Mon0x4A/custom-keyboard/resources/Kailh-Choc-Switch-Specifications.webp

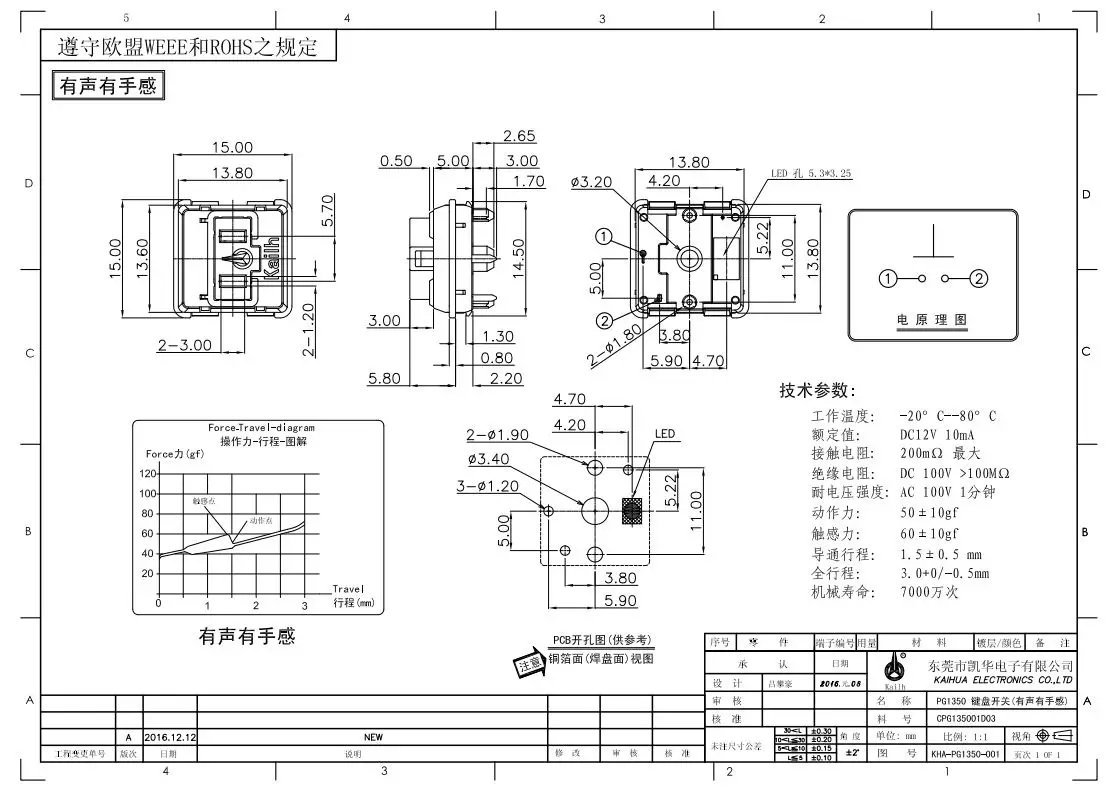
resources/Kailh-Choc-Switch-Specifications.webp
