Mon0x4A/custom-keyboard/resources/mxSwitchMechanicalDrawing.png

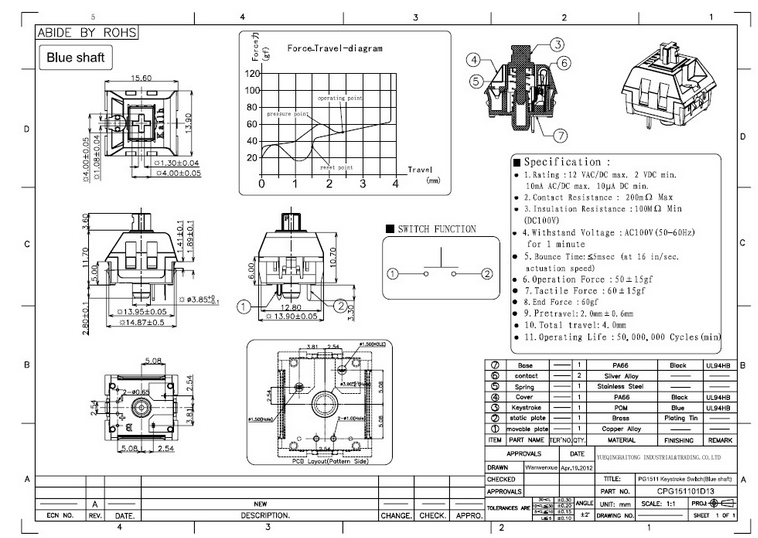
resources/mxSwitchMechanicalDrawing.png
