Mon0x4A/custom-keyboard/resources/pi-pico-pinout-diagram.png

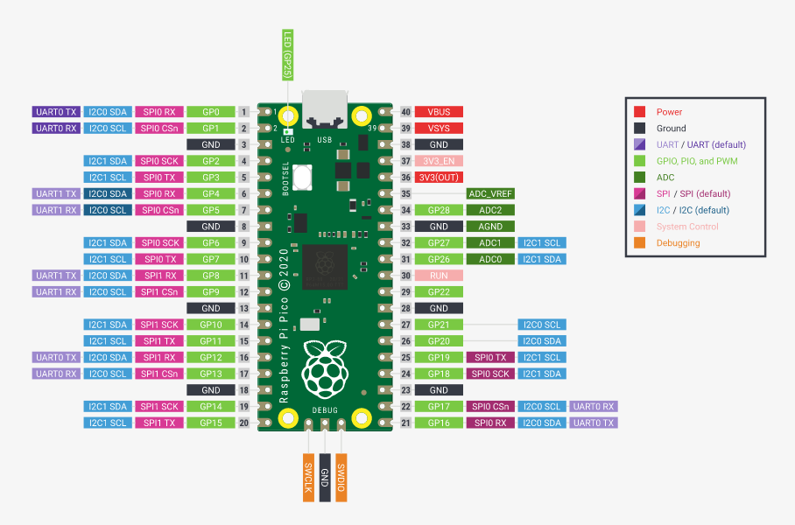
resources/pi-pico-pinout-diagram.png
