Mon0x4A/custom-keyboard/resources/stl/keyboardMk2.stl

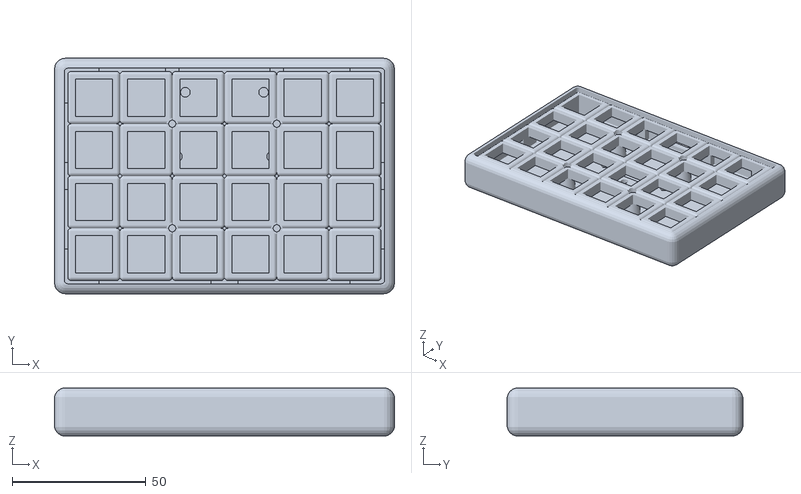
[picture p4: CAD file, 2023-02-18]
resources/stl/keyboardMk2.stl
126.9 x 87.9 x 17.9
