Mon0x4A/custom-keyboard/scad/cases/datahand-palm-rest.stl

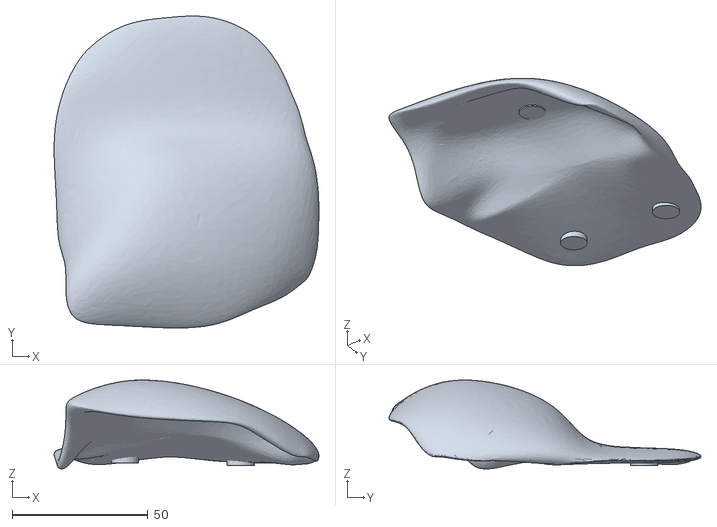
[picture p5: CAD file, 2024-03-18]
scad/cases/datahand-palm-rest.stl
97.5 x 114.8 x 32.7
