Mon0x4A/custom-keyboard/scad/lpk_dactyl/croissant-left.3mf

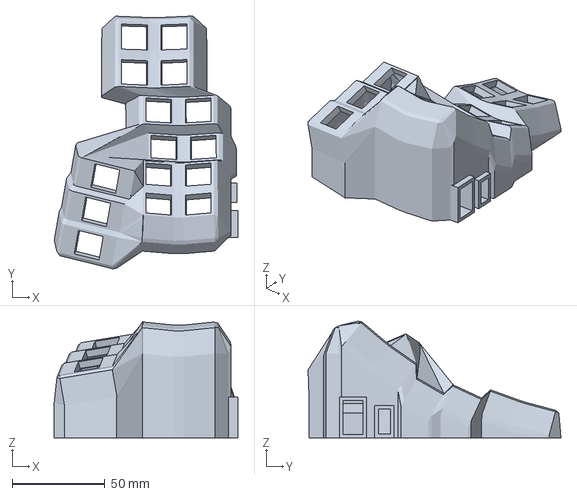
[picture p6: CAD file, 2025-09-13]
scad/lpk_dactyl/croissant-left.3mf
99.2 x 136.7 x 63.2 mm
