Mon0x4A/custom-keyboard/resources/stl/cap-shank.stl

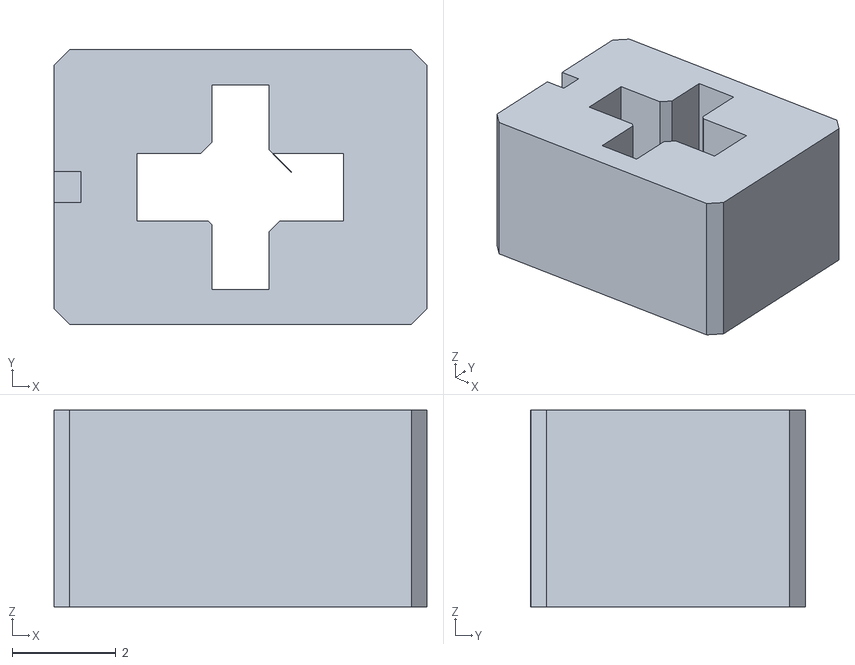
[picture p7: CAD file, 2022-06-14]
resources/stl/cap-shank.stl
7.20 x 5.30 x 3.80
