Mon0x4A/custom-keyboard/resources/stl/switch_mx.stl

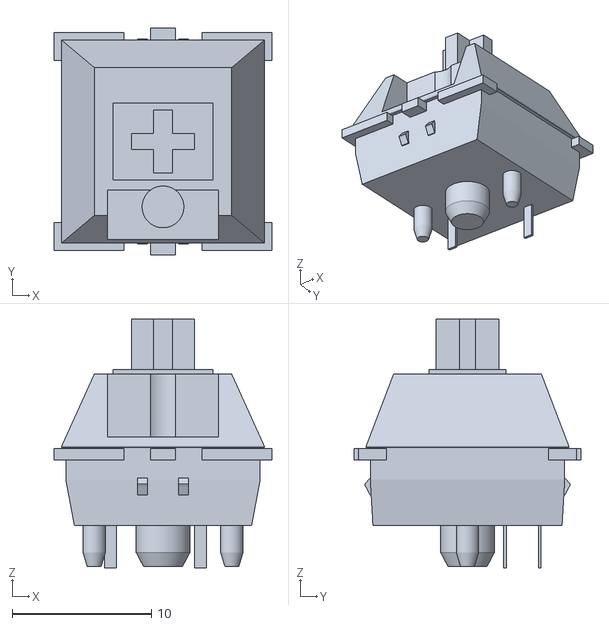
[picture p8: CAD file, 2022-06-13]
resources/stl/switch_mx.stl
15.6 x 16.3 x 17.9
