Mon0x4A/custom-keyboard/scad/lpk_dactyl/lpk_dactyl_mk2.scad

difference()
union()
{
translate([0, 0, -31.58])
    import("croissant-left.stl");
translate([100, -10, 0])
    cube([15, 30, 15]);
}
