Mon0x4A/custom-keyboard/(list of files, cad)

Other CAD files:
scad/lpk_dactyl/croissant-right.3mf
scad/keyboardMk1.scad
scad/keyboardMk2.scad
scad/keyboardMk4.scad
scad/keyboardMk6.scad
scad/backplateLeft.scad
scad/kailhKeycapMk2.scad
scad/keybordLeft.scad
scad/lpk_dactyl/key_cover.scad
scad/lpk_dactyl/usbc_mount.scad
scad/lpk_dactyl/croissant-left.stl
scad/lpk_dactyl/croissant-right.stl
