Mon0x4A/custom-keyboard/kicad/mskp/pico_ctrl_board_primary_Mk2_rev0/pico_ctrl_board_primary_Mk2_rev0.kicad_pcb

## KiCad design kicad/mskp/pico_ctrl_board_primary_Mk2_rev0/pico_ctrl_board_primary_Mk2_rev0.kicad_pcb (2024-12-22)

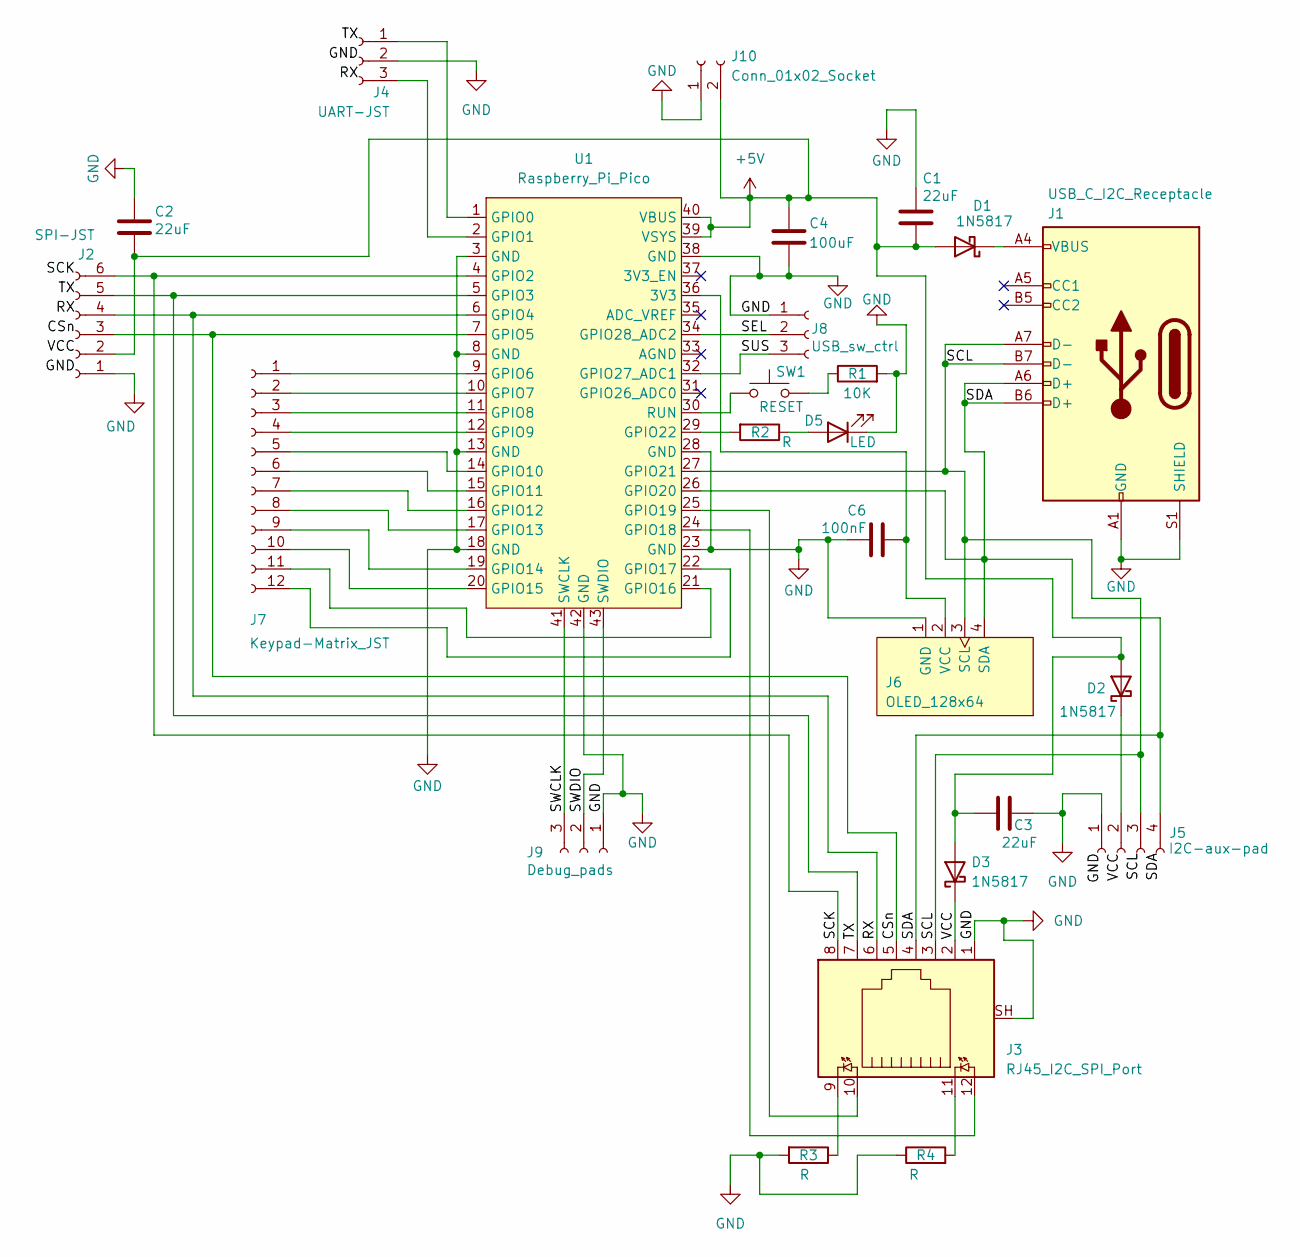
[picture p9: schematic pico_ctrl_board_primary_Mk2_rev0.kicad_sch]

Parts:
C1, C2, C3: 22uF; C_1206_3216Metric_Pad1.33x1.80mm_HandSolder
C4: 100uF; C_1206_3216Metric_Pad1.33x1.80mm_HandSolder
C6: 100nF; C_1206_3216Metric_Pad1.33x1.80mm_HandSolder
D1, D2, D3: 1N5817; D_DO-41_SOD81_P10.16mm_Horizontal
D5: LED; LED_0805_2012Metric_Pad1.15x1.40mm_HandSolder
J1: USB_C_I2C_Receptacle; USB_C_Receptacle_GCT_USB4110
J2: SPI-JST; JST_GH_SM06B-GHS-TB_1x06-1MP_P1.25mm_Horizontal
J3: RJ45_I2C_SPI_Port; RJ45_Amphenol_RJHSE538X
J4: UART-JST; JST_SH_SM03B-SRSS-TB_1x03-1MP_P1.00mm_Horizontal
J5: I2C-aux-pad; PinHeader_1x04_P2.54mm_Vertical
J6: OLED_128x64
J7: Keypad-Matrix_JST; JST_GH_SM12B-GHS-TB_1x12-1MP_P1.25mm_Horizontal
J8: USB_sw_ctrl; PinSocket_1x03_P2.54mm_Vertical
J9: Debug_pads; PinHeader_1x03_P2.54mm_Vertical
J10: Conn_01x02_Socket; PinHeader_1x02_P2.54mm_Vertical
R1: 10K; R_Axial_DIN0207_L6.3mm_D2.5mm_P7.62mm_Horizontal
R2, R3, R4: R; R_Axial_DIN0207_L6.3mm_D2.5mm_P7.62mm_Horizontal
SW1: RESET; SW_SPST_Omron_B3FS-101xP
U1: Raspberry_Pi_Pico

Connections:
+5V: C1.1, C2.1, C3.2, C4.1, D1.2 (A), D2.2 (A), D3.2 (A), J2.2, J10.2, U1.39 (VSYS), U1.40 (VBUS)
/CSn: J2.3, J3.5, U1.7 (GPIO5)
/RX: J2.4, J3.6, U1.6 (GPIO4)
/SCK: J2.6, J3.8, U1.4 (GPIO2)
/SCL: J1.A7 (D-), J1.B7 (D-), J3.3, J5.3, J6.3 (SCL), U1.27 (GPIO21)
/SDA: J1.A6 (D+), J1.B6 (D+), J3.4, J5.4, J6.4 (SDA), U1.26 (GPIO20)
/SEL: J8.2, U1.34 (GPIO28_ADC2)
/SUS: J8.3, U1.32 (GPIO27_ADC1)
/SWCLK: J9.3, U1.41 (SWCLK)
/SWDIO: J9.2, U1.43 (SWDIO)
/TX: J2.5, J3.7, U1.5 (GPIO3)
/VCC: D3.1 (K), J3.2
GND: C1.2, C2.2, C3.1, C4.2, C6.2, D5.1 (K), J1.A1 (GND), J1.A12 (GND), J1.B1 (GND), J1.B12 (GND), J1.S1 (SHIELD), J2.1, J3.1, J3.SH, J4.2, J5.1, J6.1 (GND), J8.1, J9.1, J10.1, R1.2, R3.2, R4.1, U1.3 (GND), U1.8 (GND), U1.13 (GND), U1.18 (GND), U1.23 (GND), U1.28 (GND), U1.38 (GND), U1.42 (GND)
unnamed: D1.1 (K), J1.A4 (VBUS), J1.A9 (VBUS), J1.B4 (VBUS), J1.B9 (VBUS)
unnamed: D2.1 (K), J5.2
unnamed: D5.2 (A), R2.1
unnamed: J3.9, R3.1
unnamed: J3.11, R4.2
unnamed: J4.1, U1.1 (GPIO0)
unnamed: J4.3, U1.2 (GPIO1)
unnamed: C6.1, J6.2 (VCC), U1.36 (3V3)
unnamed: J7.1, U1.9 (GPIO6)
unnamed: J7.2, U1.10 (GPIO7)
unnamed: J7.3, U1.11 (GPIO8)
unnamed: J7.4, U1.12 (GPIO9)
unnamed: J7.5, U1.14 (GPIO10)
unnamed: J7.6, U1.15 (GPIO11)
unnamed: J7.7, U1.16 (GPIO12)
unnamed: J7.8, U1.17 (GPIO13)
unnamed: J7.9, U1.19 (GPIO14)
unnamed: J7.10, U1.20 (GPIO15)
unnamed: J7.11, U1.21 (GPIO16)
unnamed: J7.12, U1.22 (GPIO17)
unnamed: R1.1, SW1.2
unnamed: J3.12, U1.24 (GPIO18)
unnamed: J3.10, U1.25 (GPIO19)
unnamed: R2.2, U1.29 (GPIO22)
unnamed: SW1.1, U1.30 (RUN)

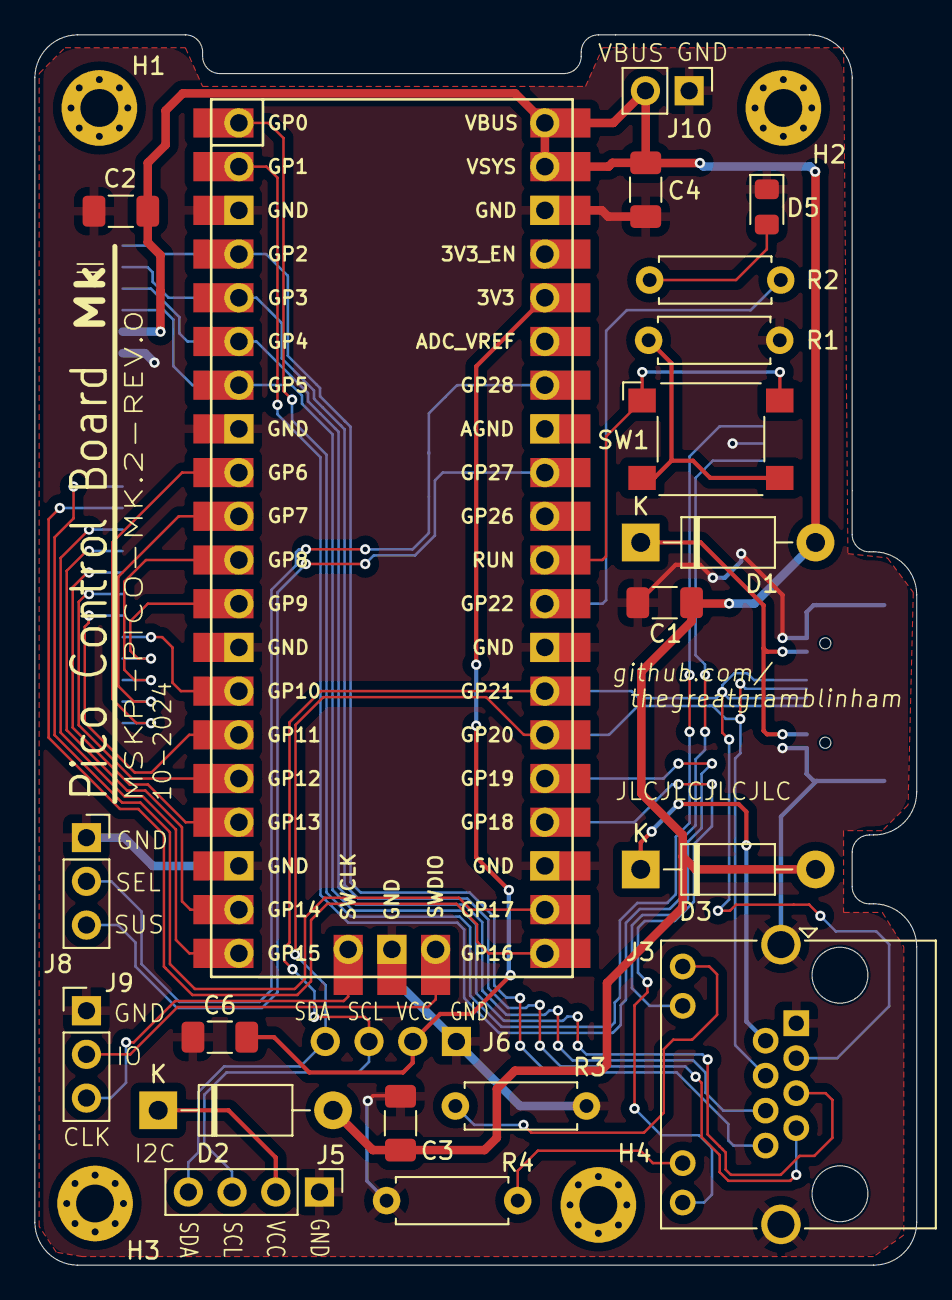
[picture p10: board pico_ctrl_board_primary_Mk2_rev0.kicad_pcb from above]

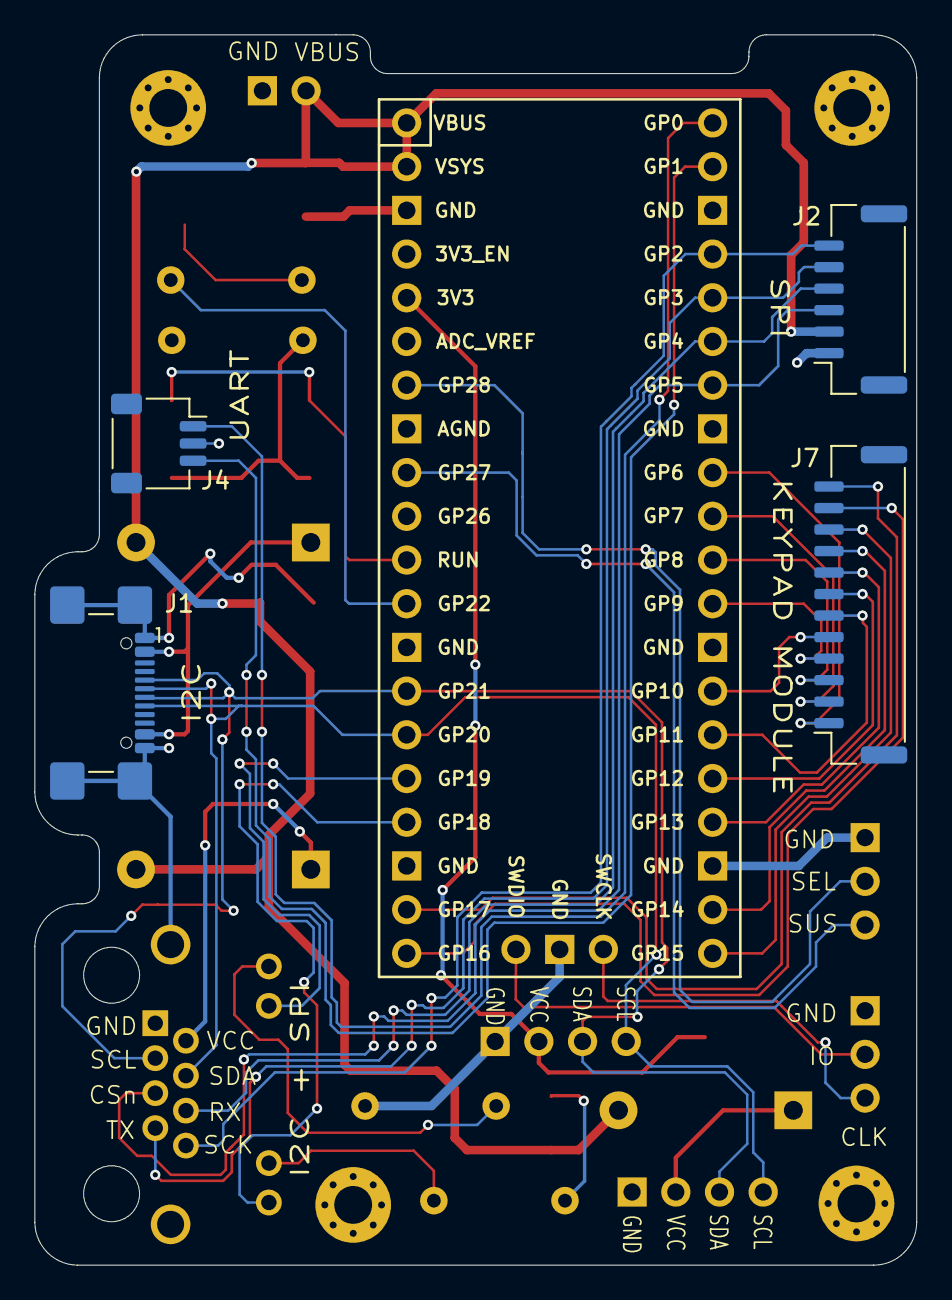
[picture p11: board pico_ctrl_board_primary_Mk2_rev0.kicad_pcb from below]

Board: 2 copper layers, 51.2 x 71.5 mm, 29 parts (4 on the bottom side), 38 nets.

Other parts of the board:
H1, H2, H3, H4: MountingHole_2.2mm_M2_Pad_Via
