Mon0x4A/custom-keyboard/kicad/mskp/io_ctrl_board_secondary_Mk2_rev0/io_ctrl_board_secondary_Mk2_rev0.kicad_pcb

## KiCad design kicad/mskp/io_ctrl_board_secondary_Mk2_rev0/io_ctrl_board_secondary_Mk2_rev0.kicad_pcb (2024-12-22)

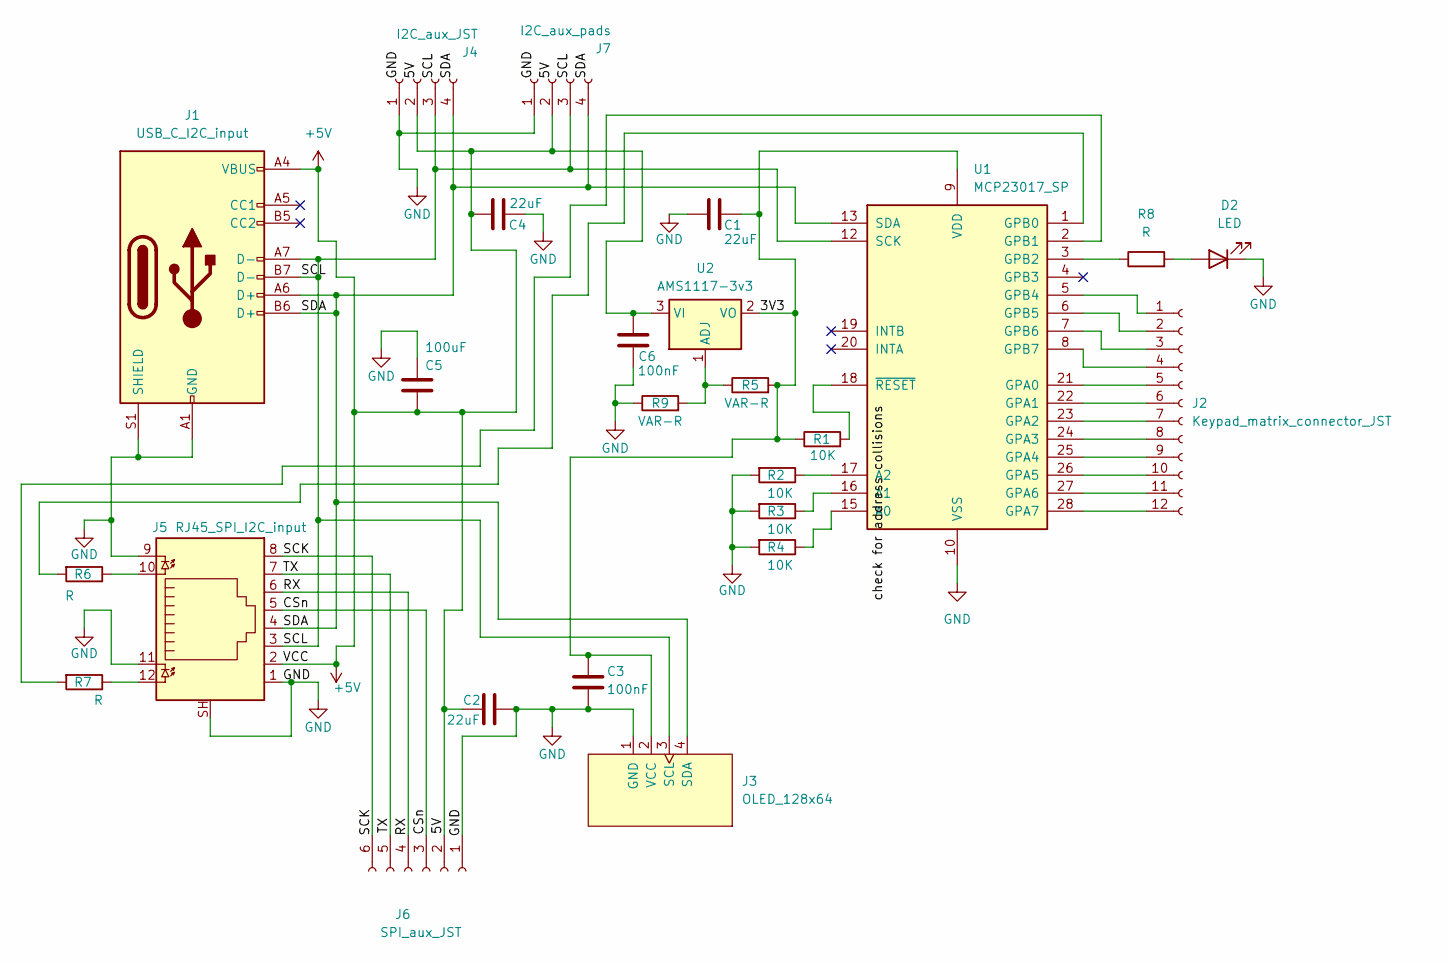
[picture p12: schematic io_ctrl_board_secondary_Mk2_rev0.kicad_sch]

Parts:
C1, C2, C4: 22uF; C_1206_3216Metric_Pad1.33x1.80mm_HandSolder
C3, C6: 100nF; C_1206_3216Metric_Pad1.33x1.80mm_HandSolder
C5: 100uF; C_1206_3216Metric_Pad1.33x1.80mm_HandSolder
D2: LED; LED_0805_2012Metric_Pad1.15x1.40mm_HandSolder
J1: USB_C_I2C_input; USB_C_Receptacle_GCT_USB4110
J2: Keypad_matrix_connector_JST; JST_GH_SM12B-GHS-TB_1x12-1MP_P1.25mm_Horizontal
J3: OLED_128x64
J4: I2C_aux_JST; JST_GH_SM04B-GHS-TB_1x04-1MP_P1.25mm_Horizontal
J5: RJ45_SPI_I2C_input; RJ45_Amphenol_RJHSE538X
J6: SPI_aux_JST; JST_GH_SM06B-GHS-TB_1x06-1MP_P1.25mm_Horizontal
J7: I2C_aux_pads; PinSocket_1x04_P2.54mm_Vertical
R1, R2, R3, R4: 10K; R_Axial_DIN0207_L6.3mm_D2.5mm_P7.62mm_Horizontal
R5, R9: VAR-R; R_Axial_DIN0207_L6.3mm_D2.5mm_P7.62mm_Horizontal
R6, R7, R8: R; R_Axial_DIN0207_L6.3mm_D2.5mm_P7.62mm_Horizontal
U1: MCP23017_SP; DIP-28_W7.62mm_Socket
U2: AMS1117-3v3; SOT-223-3_TabPin2

Connections:
+5V: C2.2, C4.1, C5.1, C6.2, J1.A4 (VBUS), J1.A9 (VBUS), J1.B4 (VBUS), J1.B9 (VBUS), J4.2, J5.2, J6.2, J7.2, U2.3 (VI)
/3V3: C1.1, C3.1, J3.2 (VCC), R1.1, R5.2, U1.9 (VDD), U2.2 (VO)
/CSn: J5.5, J6.3
/RX: J5.6, J6.4
/SCK: J5.8, J6.6
/SCL: J1.A7 (D-), J1.B7 (D-), J3.3 (SCL), J4.3, J5.3, J7.3, U1.12 (SCK)
/SDA: J1.A6 (D+), J1.B6 (D+), J3.4 (SDA), J4.4, J5.4, J7.4, U1.13 (SDA)
/TX: J5.7, J6.5
GND: C1.2, C2.1, C3.2, C4.2, C5.2, C6.1, D2.1 (K), J1.A1 (GND), J1.A12 (GND), J1.B1 (GND), J1.B12 (GND), J1.S1 (SHIELD), J3.1 (GND), J4.1, J5.1, J5.9, J5.11, J5.SH, J6.1, J7.1, R2.2, R3.2, R4.2, R9.1, U1.10 (VSS)
unnamed: D2.2 (A), R8.2
unnamed: J2.1, U1.5 (GPB4)
unnamed: J2.2, U1.6 (GPB5)
unnamed: J2.3, U1.7 (GPB6)
unnamed: J2.4, U1.8 (GPB7)
unnamed: J2.5, U1.21 (GPA0)
unnamed: J2.6, U1.22 (GPA1)
unnamed: J2.7, U1.23 (GPA2)
unnamed: J2.8, U1.24 (GPA3)
unnamed: J2.9, U1.25 (GPA4)
unnamed: J2.10, U1.26 (GPA5)
unnamed: J2.11, U1.27 (GPA6)
unnamed: J2.12, U1.28 (GPA7)
unnamed: J5.10, R6.1
unnamed: J5.12, R7.1
unnamed: R4.1, U1.15 (A0)
unnamed: R3.1, U1.16 (A1)
unnamed: R2.1, U1.17 (A2)
unnamed: R6.2, U1.1 (GPB0)
unnamed: R7.2, U1.2 (GPB1)
unnamed: R8.1, U1.3 (GPB2)
unnamed: R1.2, U1.18 (~RESET)
unnamed: R5.1, R9.2, U2.1 (ADJ)

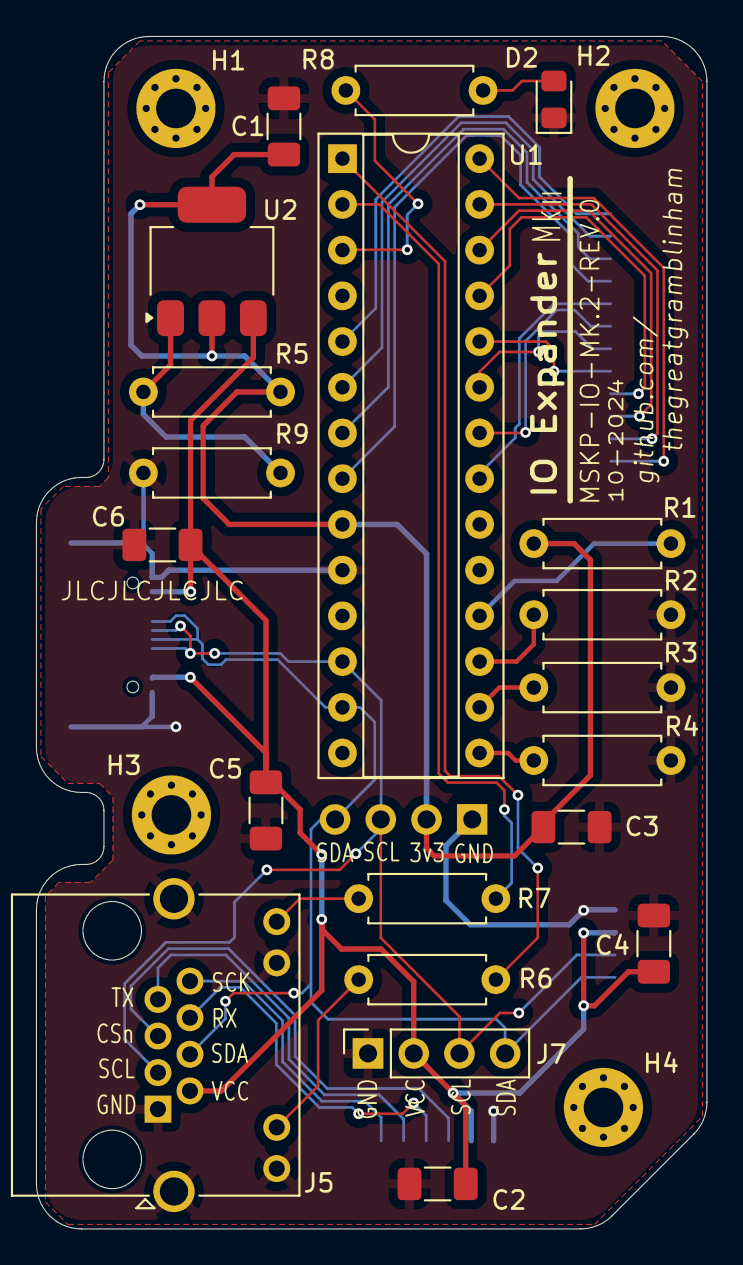
[picture p13: board io_ctrl_board_secondary_Mk2_rev0.kicad_pcb from above]

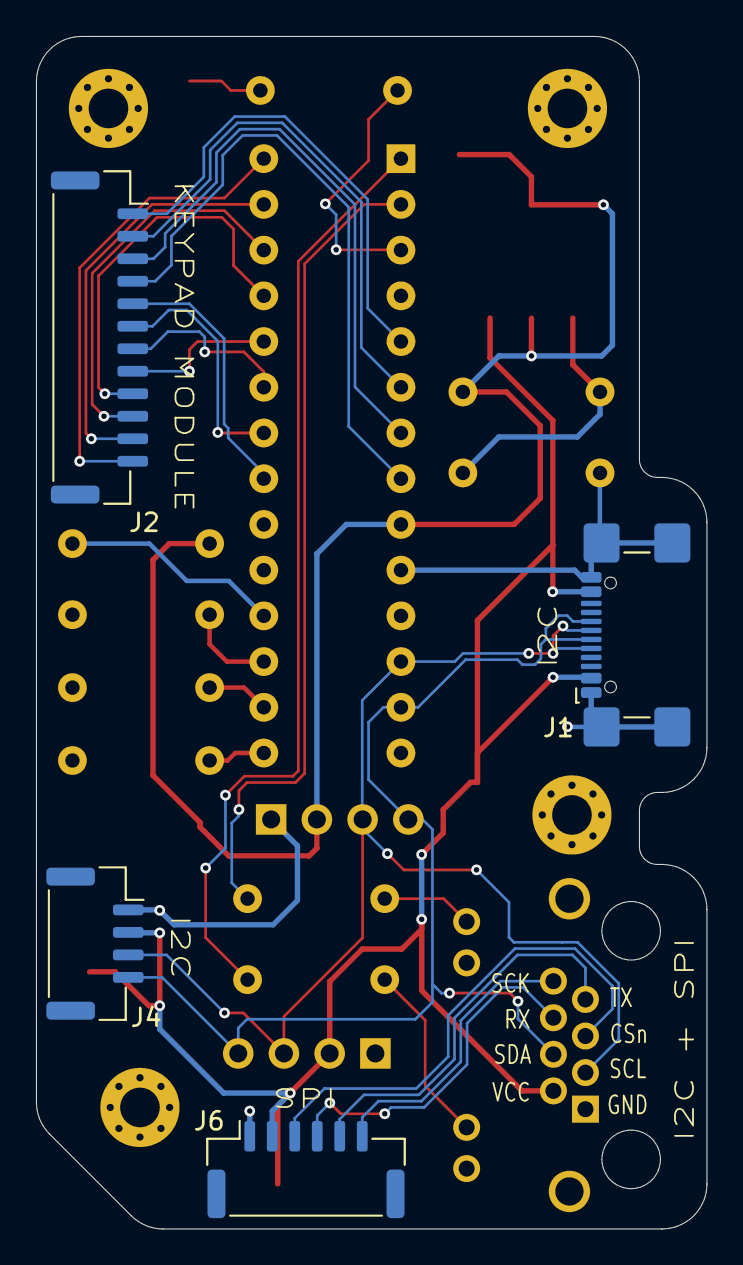
[picture p14: board io_ctrl_board_secondary_Mk2_rev0.kicad_pcb from below]

Board: 2 copper layers, 37.2 x 66.2 mm, 29 parts (4 on the bottom side), 32 nets.

Other parts of the board:
H1, H2, H3, H4: MountingHole_2.2mm_M2_Pad_Via
