Mon0x4A/custom-keyboard/kicad/mskp/dual_axis_i2c_analog_mouse_Mk1_rev0/dual_axis_i2c_analog_mouse_Mk1_rev0.kicad_pcb

## KiCad design kicad/mskp/dual_axis_i2c_analog_mouse_Mk1_rev0/dual_axis_i2c_analog_mouse_Mk1_rev0.kicad_pcb (2024-12-22)

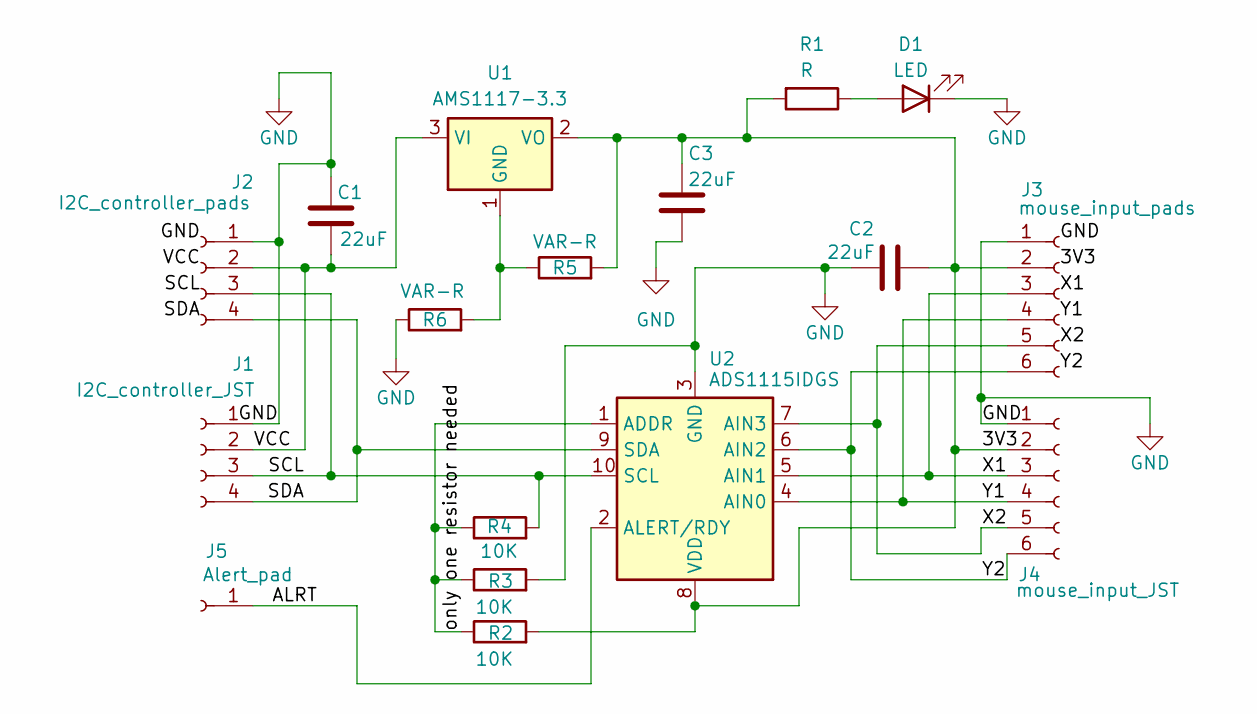
[picture p15: schematic dual_axis_i2c_analog_mouse_Mk1_rev0.kicad_sch]

Parts:
C1, C2, C3: 22uF; C_1206_3216Metric_Pad1.33x1.80mm_HandSolder
D1: LED; LED_0805_2012Metric_Pad1.15x1.40mm_HandSolder
J1: I2C_controller_JST; JST_GH_SM04B-GHS-TB_1x04-1MP_P1.25mm_Horizontal
J2: I2C_controller_pads; PinSocket_1x04_P2.54mm_Vertical
J3: mouse_input_pads; PinSocket_1x06_P2.54mm_Vertical
J4: mouse_input_JST; JST_GH_SM06B-GHS-TB_1x06-1MP_P1.25mm_Horizontal
J5: Alert_pad; PinSocket_1x01_P2.54mm_Vertical
R1: R; R_Axial_DIN0207_L6.3mm_D2.5mm_P7.62mm_Horizontal
R2, R3, R4: 10K; R_Axial_DIN0207_L6.3mm_D2.5mm_P7.62mm_Horizontal
R5, R6: VAR-R; R_Axial_DIN0207_L6.3mm_D2.5mm_P7.62mm_Horizontal
U1: AMS1117-3.3; SOT-223-3_TabPin2
U2: ADS1115IDGS; TSSOP-10_3x3mm_P0.5mm

Connections:
/3V3: C2.2, C3.1, J3.2, J4.2, R1.2, R2.2, R5.2, U1.2 (VO), U2.8 (VDD)
/ALRT: J5.1, U2.2 (ALERT/RDY)
/SCL: J1.3, J2.3, R4.2, U2.10 (SCL)
/SDA: J1.4, J2.4, U2.9 (SDA)
/VCC: C1.2, J1.2, J2.2, U1.3 (VI)
/X1: J3.3, J4.3, U2.5 (AIN1)
/X2: J3.5, J4.5, U2.7 (AIN3)
/Y1: J3.4, J4.4, U2.4 (AIN0)
/Y2: J3.6, J4.6, U2.6 (AIN2)
/only one resistor needed: R2.1, R3.1, R4.1, U2.1 (ADDR)
GND: C1.1, C2.1, C3.2, D1.1 (K), J1.1, J2.1, J3.1, J4.1, R3.2, R6.1, U2.3 (GND)
unnamed: D1.2 (A), R1.1
unnamed: R5.1, R6.2, U1.1 (GND)

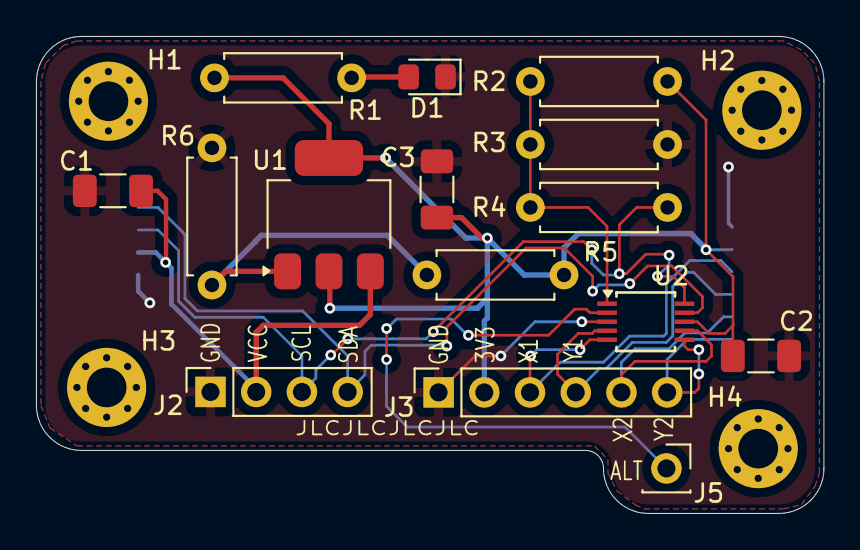
[picture p16: board dual_axis_i2c_analog_mouse_Mk1_rev0.kicad_pcb from above]

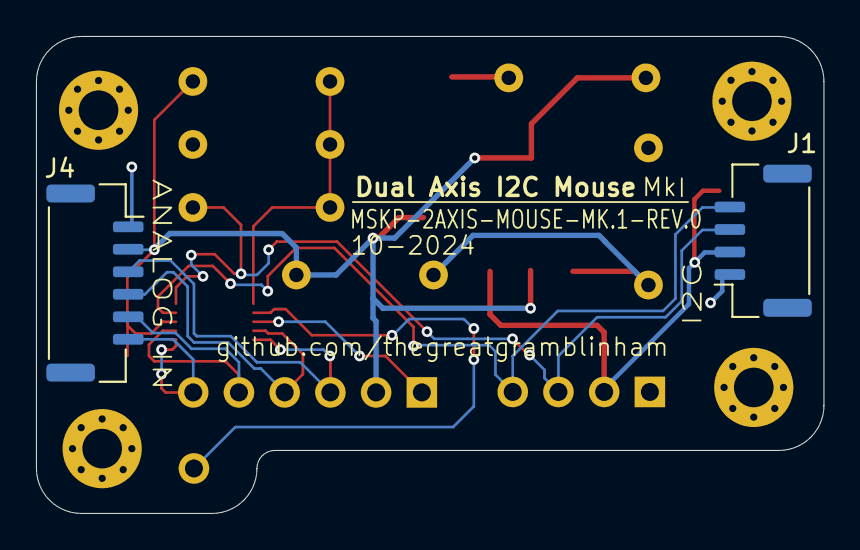
[picture p17: board dual_axis_i2c_analog_mouse_Mk1_rev0.kicad_pcb from below]

Board: 2 copper layers, 43.8 x 26.5 mm, 21 parts (2 on the bottom side), 13 nets.

Other parts of the board:
H1, H2, H3, H4: MountingHole_2.2mm_M2_Pad_Via
