Mon0x4A/custom-keyboard/kicad/mskp/lpk20_mx_keypad_L_Mk1_rev0/lpk20_mx_keypad_L_Mk1_rev0.kicad_pcb

## KiCad design kicad/mskp/lpk20_mx_keypad_L_Mk1_rev0/lpk20_mx_keypad_L_Mk1_rev0.kicad_pcb (2024-12-22)

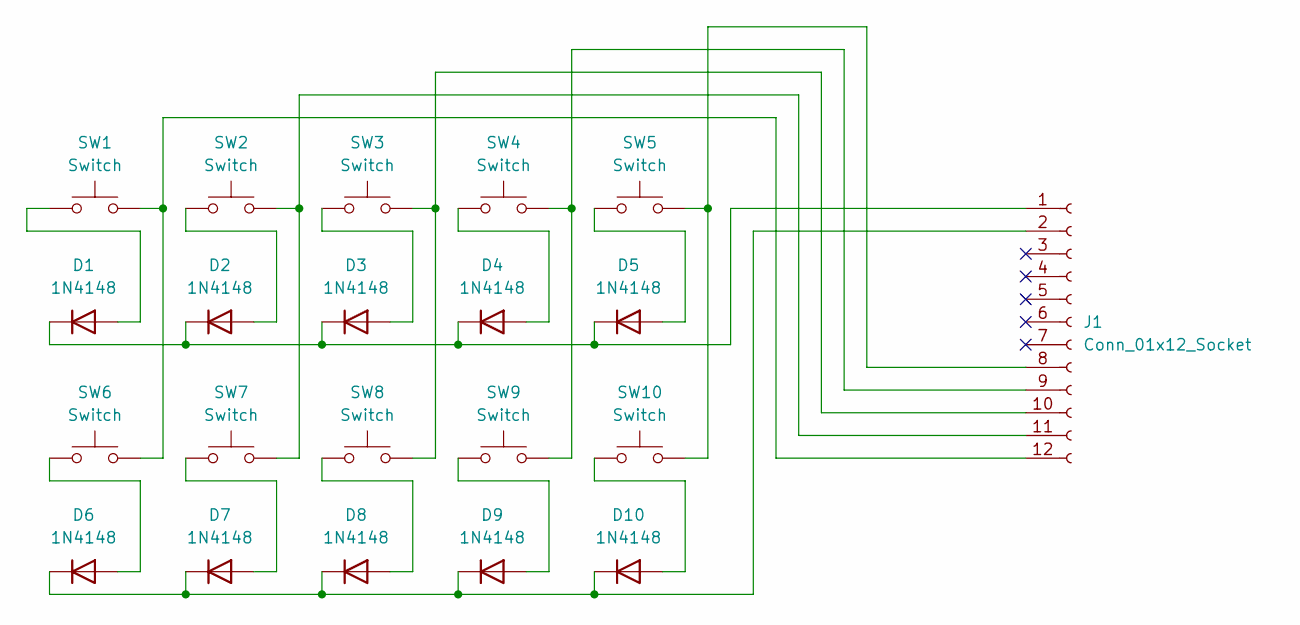
[picture p18: schematic lpk20_mx_keypad_L_Mk1_rev0.kicad_sch]

Parts:
D1, D2, D3, D4, D5, D6, D7, D8, D9, D10: 1N4148; D_DO-35_SOD27_P7.62mm_Horizontal
J1: Conn_01x12_Socket; JST_GH_BM12B-GHS-TBT_1x12-1MP_P1.25mm_Vertical
SW1, SW2, SW3, SW4, SW5, SW6, SW7, SW8, SW9, SW10: Switch; Hotswap_MX_Plated_1.00u

Connections:
unnamed: D1.2 (A), SW1.1
unnamed: D1.1 (K), D2.1 (K), D3.1 (K), D4.1 (K), D5.1 (K), J1.1
unnamed: D2.2 (A), SW2.1
unnamed: D3.2 (A), SW3.1
unnamed: D4.2 (A), SW4.1
unnamed: D5.2 (A), SW5.1
unnamed: D6.2 (A), SW6.1
unnamed: D7.2 (A), SW7.1
unnamed: D8.2 (A), SW8.1
unnamed: D9.2 (A), SW9.1
unnamed: D10.2 (A), SW10.1
unnamed: D6.1 (K), D7.1 (K), D8.1 (K), D9.1 (K), D10.1 (K), J1.2
unnamed: J1.8, SW5.2, SW10.2
unnamed: J1.9, SW4.2, SW9.2
unnamed: J1.10, SW3.2, SW8.2
unnamed: J1.11, SW2.2, SW7.2
unnamed: J1.12, SW1.2, SW6.2

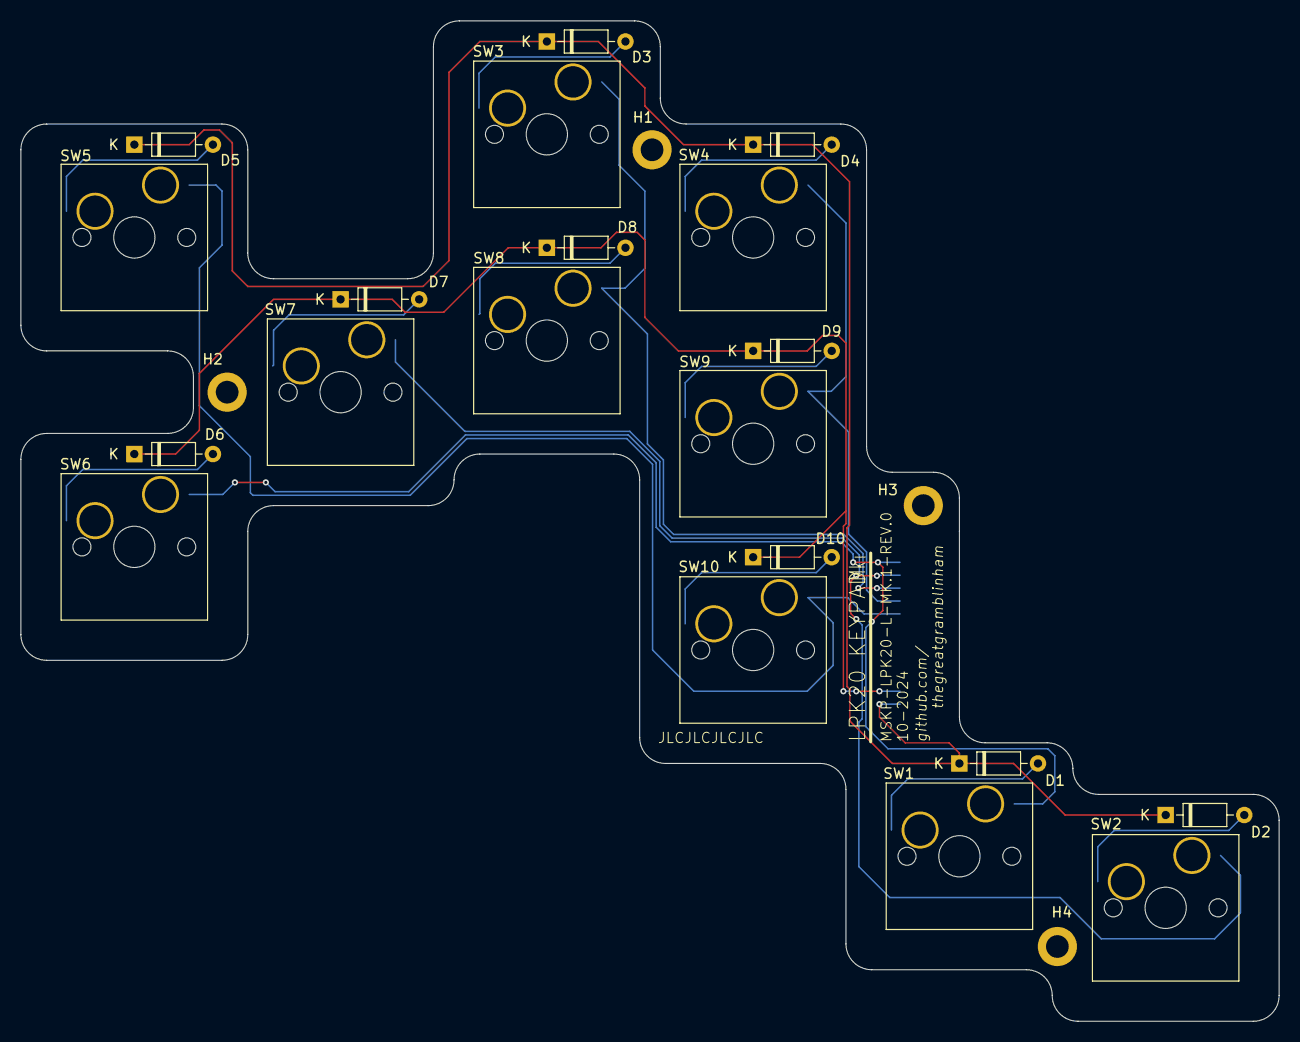
[picture p19: board lpk20_mx_keypad_L_Mk1_rev0.kicad_pcb from above]

Board: 2 copper layers, 122.0 x 97.0 mm, 25 parts (1 on the bottom side), 17 nets.

Other parts of the board:
H1, H2, H3, H4: MountingHole_2.2mm_M2_ISO14580_Pad
