Mon0x4A/custom-keyboard/kicad/mskp/usbc_switch_board_Mk1_rev0/usbc_switch_board_Mk1_rev0.kicad_pcb

## KiCad design kicad/mskp/usbc_switch_board_Mk1_rev0/usbc_switch_board_Mk1_rev0.kicad_pcb (2024-12-22)

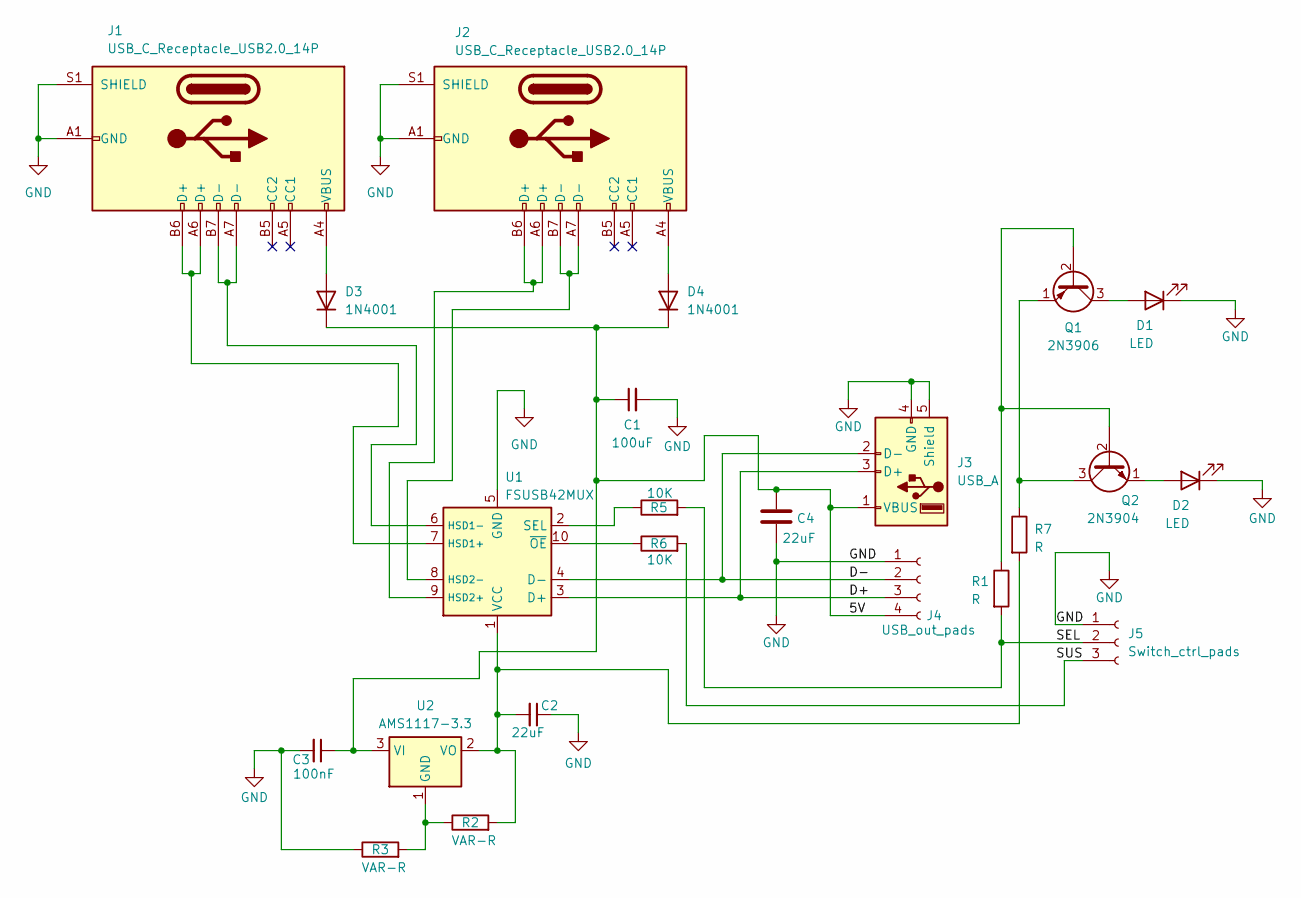
[picture p20: schematic usbc_switch_board_Mk1_rev0.kicad_sch]

Parts:
C1: 100uF; C_1206_3216Metric_Pad1.33x1.80mm_HandSolder
C2, C4: 22uF; C_1206_3216Metric_Pad1.33x1.80mm_HandSolder
C3: 100nF; C_1206_3216Metric_Pad1.33x1.80mm_HandSolder
D1, D2: LED; LED_0805_2012Metric_Pad1.15x1.40mm_HandSolder
D3, D4: 1N4001; D_DO-41_SOD81_P10.16mm_Horizontal
J1, J2: USB_C_Receptacle_USB2.0_14P; USB_C_Receptacle_GCT_USB4110
J3: USB_A; USB_A_CONNFLY_DS1095-WNR0
J4: USB_out_pads; PinHeader_1x04_P2.54mm_Vertical
J5: Switch_ctrl_pads; PinSocket_1x03_P2.54mm_Vertical
Q1: 2N3906; TO-92_Inline
Q2: 2N3904; TO-92_Inline
R1, R7: R; R_Axial_DIN0207_L6.3mm_D2.5mm_P7.62mm_Horizontal
R2, R3: VAR-R; R_Axial_DIN0207_L6.3mm_D2.5mm_P7.62mm_Horizontal
R5, R6: 10K; R_Axial_DIN0207_L6.3mm_D2.5mm_P7.62mm_Horizontal
U1: FSUSB42MUX; MSOP-10_3x3mm_P0.5mm
U2: AMS1117-3.3; SOT-223-3_TabPin2

Connections:
/5V: C1.1, C3.1, C4.1, D3.1 (K), D4.1 (K), J3.1 (VBUS), J4.4, U2.3 (VI)
/D+: J3.3 (D+), J4.3, U1.3 (D+)
/D-: J3.2 (D-), J4.2, U1.4 (D-)
/SEL: J5.2, R1.2, R5.2
GND: C1.2, C2.1, C3.2, C4.2, D1.1 (K), D2.1 (K), J1.A1 (GND), J1.A12 (GND), J1.B1 (GND), J1.B12 (GND), J1.S1 (SHIELD), J2.A1 (GND), J2.A12 (GND), J2.B1 (GND), J2.B12 (GND), J2.S1 (SHIELD), J3.4 (GND), J3.5 (Shield), J4.1, J5.1, R3.1, U1.5 (GND)
unnamed: D1.2 (A), Q1.3 (C)
unnamed: D2.2 (A), Q2.1 (E)
unnamed: D3.2 (A), J1.A4 (VBUS), J1.A9 (VBUS), J1.B4 (VBUS), J1.B9 (VBUS)
unnamed: D4.2 (A), J2.A4 (VBUS), J2.A9 (VBUS), J2.B4 (VBUS), J2.B9 (VBUS)
unnamed: J5.3, R6.2
unnamed: Q1.2 (B), Q2.2 (B), R1.1
unnamed: Q1.1 (E), Q2.3 (C), R7.1
unnamed: J1.A6 (D+), J1.B6 (D+), U1.7 (HSD1+)
unnamed: J1.A7 (D-), J1.B7 (D-), U1.6 (HSD1-)
unnamed: J2.A6 (D+), J2.B6 (D+), U1.9 (HSD2+)
unnamed: J2.A7 (D-), J2.B7 (D-), U1.8 (HSD2-)
unnamed: R5.1, U1.2 (SEL)
unnamed: C2.2, R2.2, R7.2, U1.1 (VCC), U2.2 (VO)
unnamed: R6.1, U1.10 (~OE)
unnamed: R2.1, R3.2, U2.1 (GND)

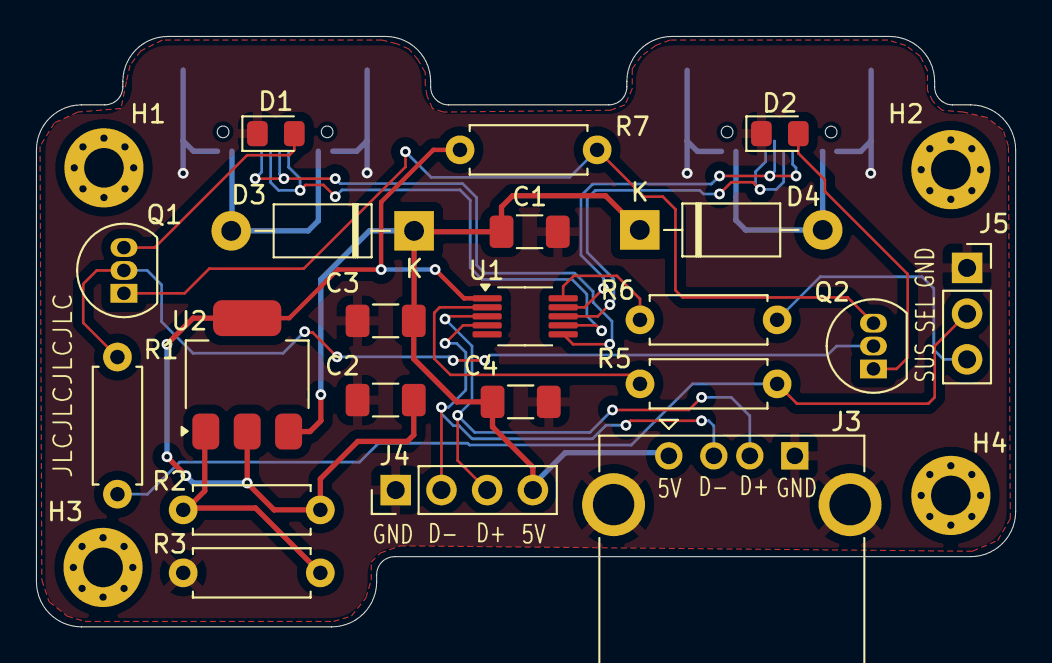
[picture p21: board usbc_switch_board_Mk1_rev0.kicad_pcb from above]

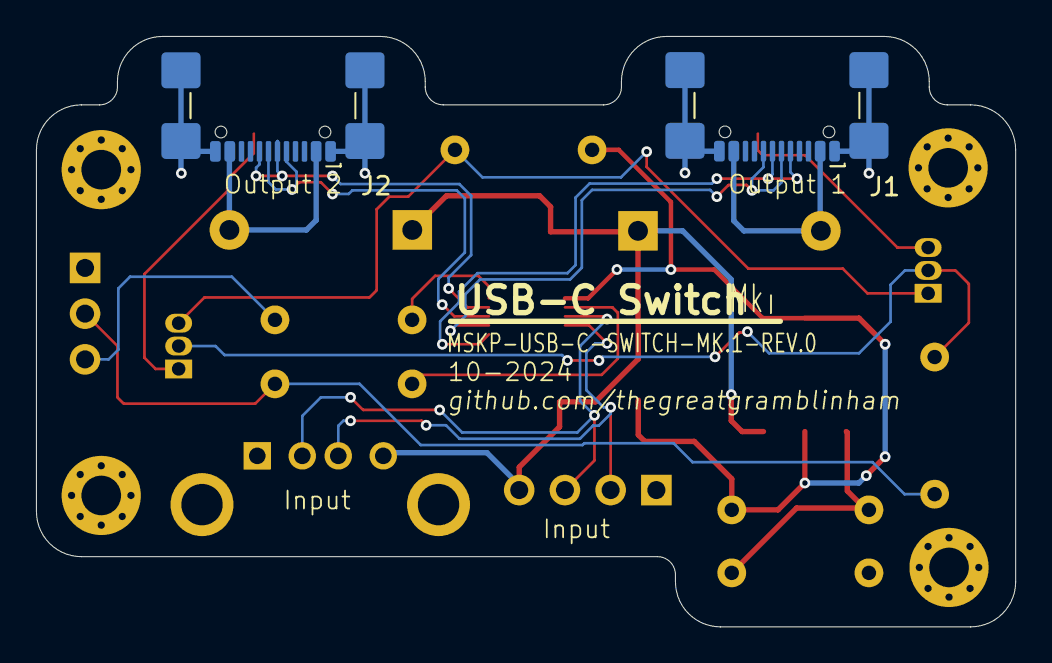
[picture p22: board usbc_switch_board_Mk1_rev0.kicad_pcb from below]

Board: 2 copper layers, 54.4 x 32.8 mm, 27 parts (2 on the bottom side), 20 nets.

Other parts of the board:
H1, H2, H3, H4: MountingHole_2.2mm_M2_Pad_Via
