Mon0x4A/custom-keyboard/kicad/mskp/io_ctrl_board_secondary_Mk1_rev0/io_ctrl_board_secondary_Mk1_rev0.kicad_pcb

## KiCad design kicad/mskp/io_ctrl_board_secondary_Mk1_rev0/io_ctrl_board_secondary_Mk1_rev0.kicad_pcb (2024-03-23, an earlier design)

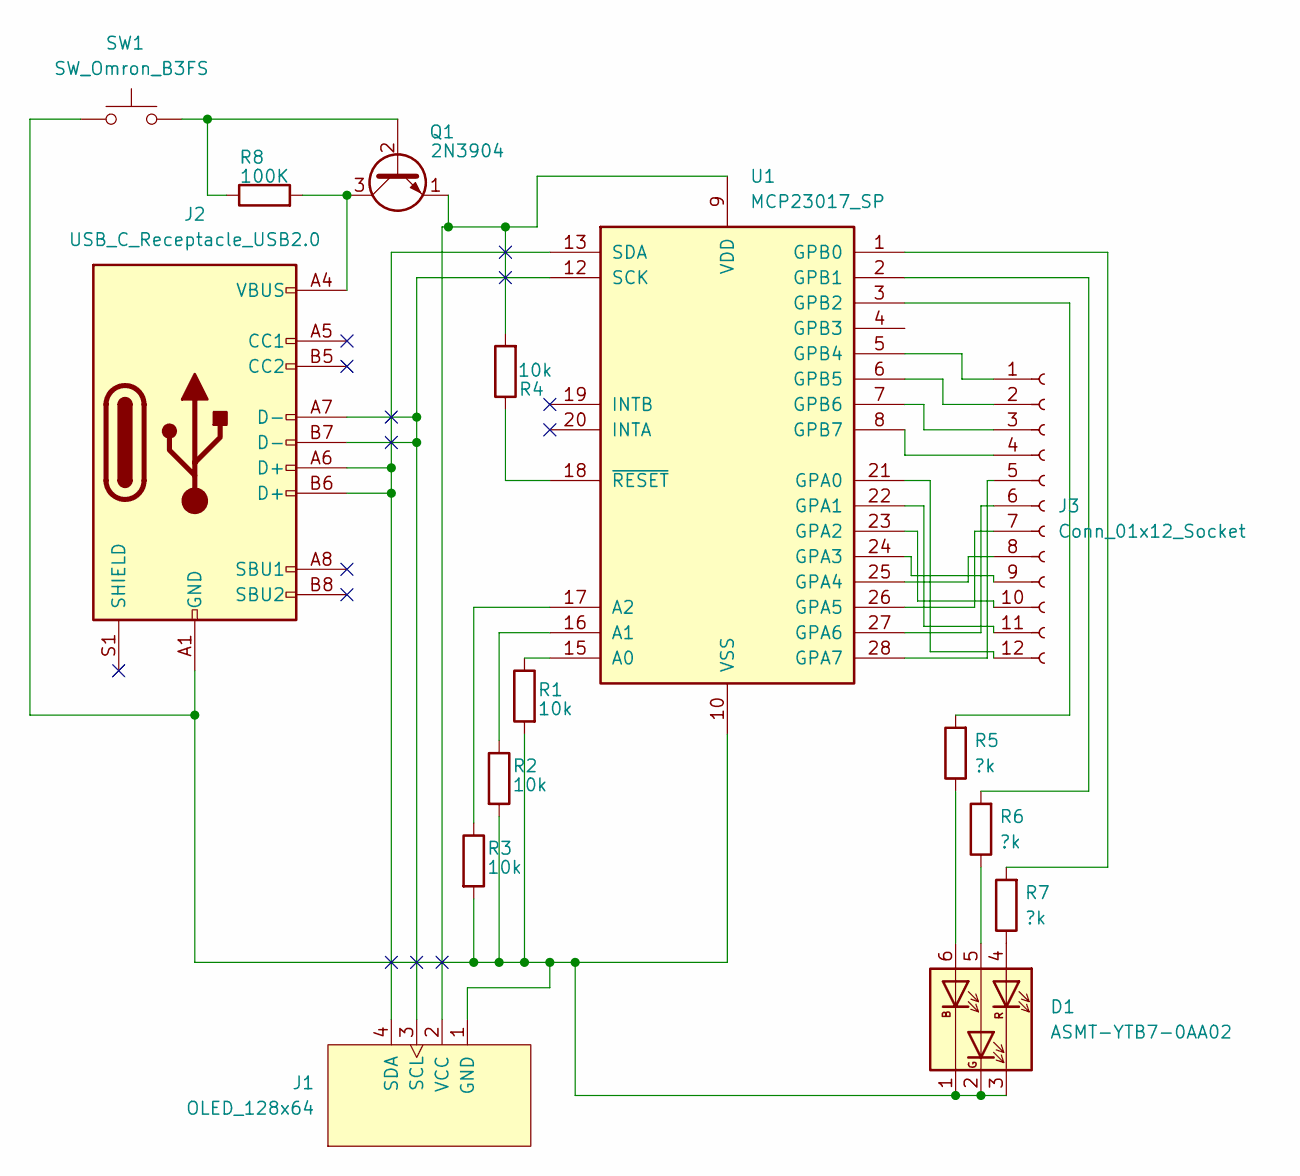
[picture p23: schematic io_ctrl_board_secondary_Mk1_rev0.kicad_sch]

Parts:
D1: ASMT-YTB7-0AA02; LED_Avago_PLCC6_3x2.8mm
J1: OLED_128x64
J2: USB_C_Receptacle_USB2.0; USB_C_Receptacle_GCT_USB4110
J3: Conn_01x12_Socket; JST_GH_SM12B-GHS-TB_1x12-1MP_P1.25mm_Horizontal
Q1: 2N3904; TO-92_Inline
R1, R2, R3, R4: 10k; R_Axial_DIN0204_L3.6mm_D1.6mm_P5.08mm_Horizontal
R5, R6, R7: ?k; R_Axial_DIN0204_L3.6mm_D1.6mm_P5.08mm_Horizontal
R8: 100K; R_Axial_DIN0204_L3.6mm_D1.6mm_P5.08mm_Horizontal
SW1: SW_Omron_B3FS; SW_SPST_Omron_B3FS-101xP
U1: MCP23017_SP; DIP-28_W7.62mm_Socket

Connections:
unnamed: D1.6 (AB), R5.1
unnamed: D1.5 (AG), R6.1
unnamed: D1.4 (AR), R7.1
unnamed: D1.1 (KB), D1.2 (KG), D1.3 (KR), J1.1 (GND), J2.A1 (GND), J2.A12 (GND), J2.B1 (GND), J2.B12 (GND), R1.2, R2.2, R3.2, SW1.2, U1.10 (VSS)
unnamed: J1.3 (SCL), J2.A7 (D-), J2.B7 (D-), U1.12 (SCK)
unnamed: J1.4 (SDA), J2.A6 (D+), J2.B6 (D+), U1.13 (SDA)
unnamed: J1.2 (VCC), Q1.1 (E), R4.2, U1.9 (VDD)
unnamed: J3.1, U1.5 (GPB4)
unnamed: J3.2, U1.6 (GPB5)
unnamed: J3.3, U1.7 (GPB6)
unnamed: J3.4, U1.8 (GPB7)
unnamed: J3.5, U1.28 (GPA7)
unnamed: J3.6, U1.27 (GPA6)
unnamed: J3.7, U1.26 (GPA5)
unnamed: J3.8, U1.25 (GPA4)
unnamed: J3.9, U1.24 (GPA3)
unnamed: J3.10, U1.23 (GPA2)
unnamed: J3.11, U1.22 (GPA1)
unnamed: J3.12, U1.21 (GPA0)
unnamed: Q1.2 (B), R8.1, SW1.1
unnamed: J2.A4 (VBUS), J2.A9 (VBUS), J2.B4 (VBUS), J2.B9 (VBUS), Q1.3 (C), R8.2
unnamed: R1.1, U1.15 (A0)
unnamed: R2.1, U1.16 (A1)
unnamed: R3.1, U1.17 (A2)
unnamed: R7.2, U1.1 (GPB0)
unnamed: R6.2, U1.2 (GPB1)
unnamed: R5.2, U1.3 (GPB2)
unnamed: R4.1, U1.18 (~RESET)
