Mon0x4A/custom-keyboard/kicad/mskp/io_ctrl_board_secondary_Mk1_rev0/io_ctrl_board_secondary_Mk1_rev0.kicad_pcb

## KiCad design kicad/mskp/io_ctrl_board_secondary_Mk1_rev0/io_ctrl_board_secondary_Mk1_rev0.kicad_pcb (continued)

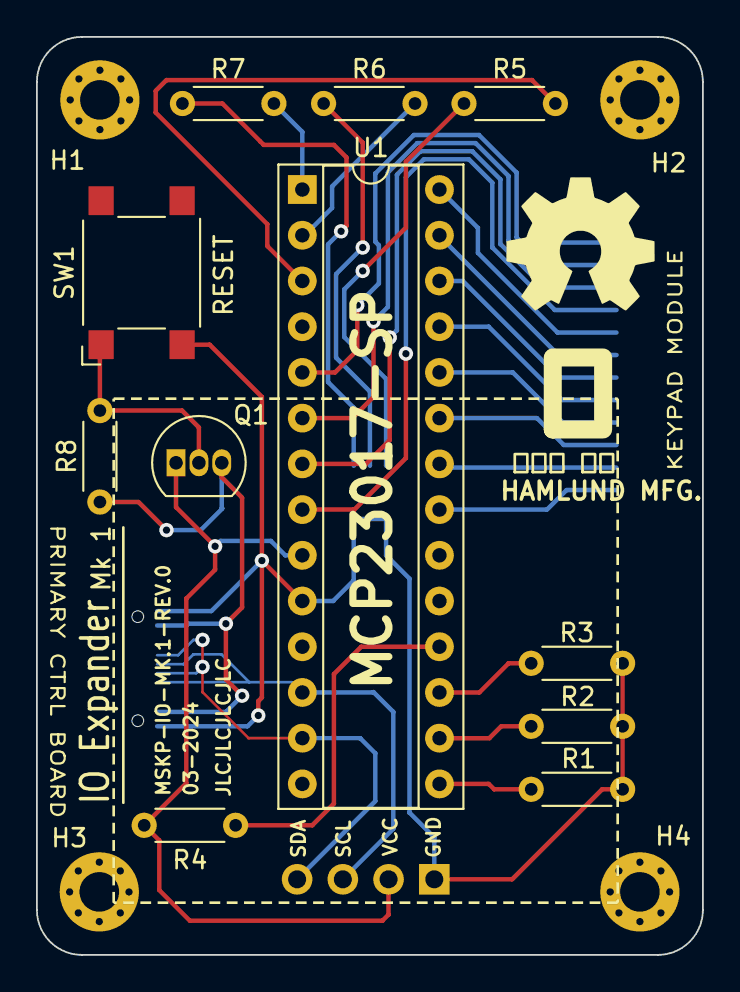
[picture p24: board io_ctrl_board_secondary_Mk1_rev0.kicad_pcb from above]

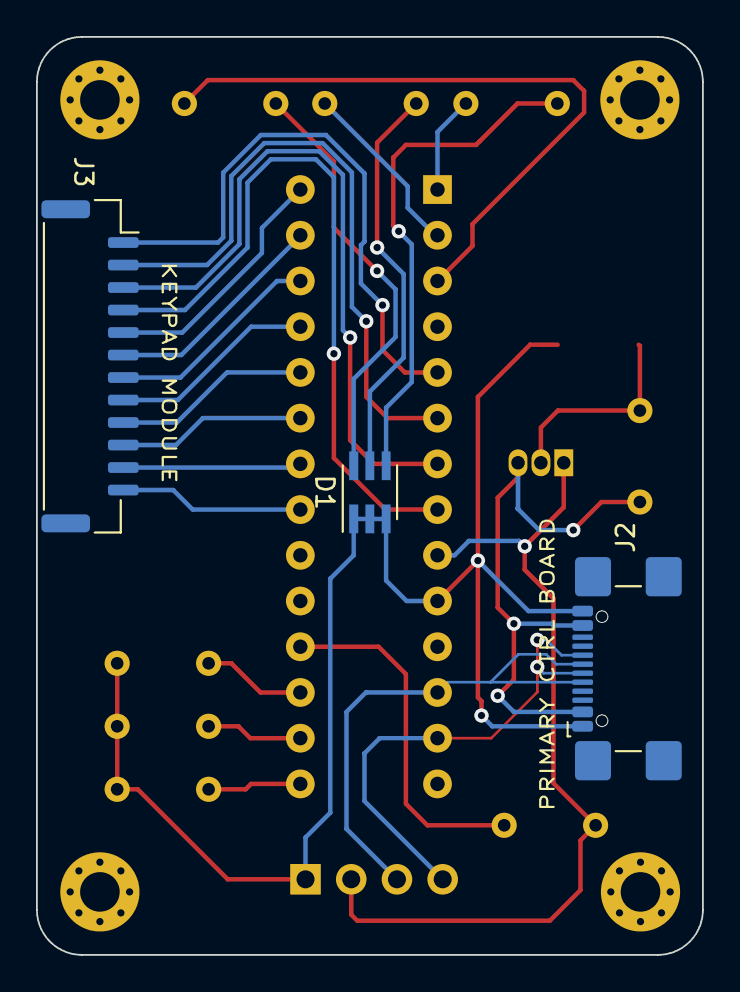
[picture p25: board io_ctrl_board_secondary_Mk1_rev0.kicad_pcb from below]

Board: 2 copper layers, 37.0 x 51.0 mm, 19 parts (3 on the bottom side), 28 nets.

Other parts of the board:
H1, H2, H3, H4: MountingHole_2.2mm_M2_Pad_Via
