Mon0x4A/custom-keyboard/kicad/mskp/pico_ctrl_board_primary_Mk1_rev0/pico_ctrl_board_primary_Mk1_rev0.kicad_pcb

## KiCad design kicad/mskp/pico_ctrl_board_primary_Mk1_rev0/pico_ctrl_board_primary_Mk1_rev0.kicad_pcb (2024-03-18, an earlier design)

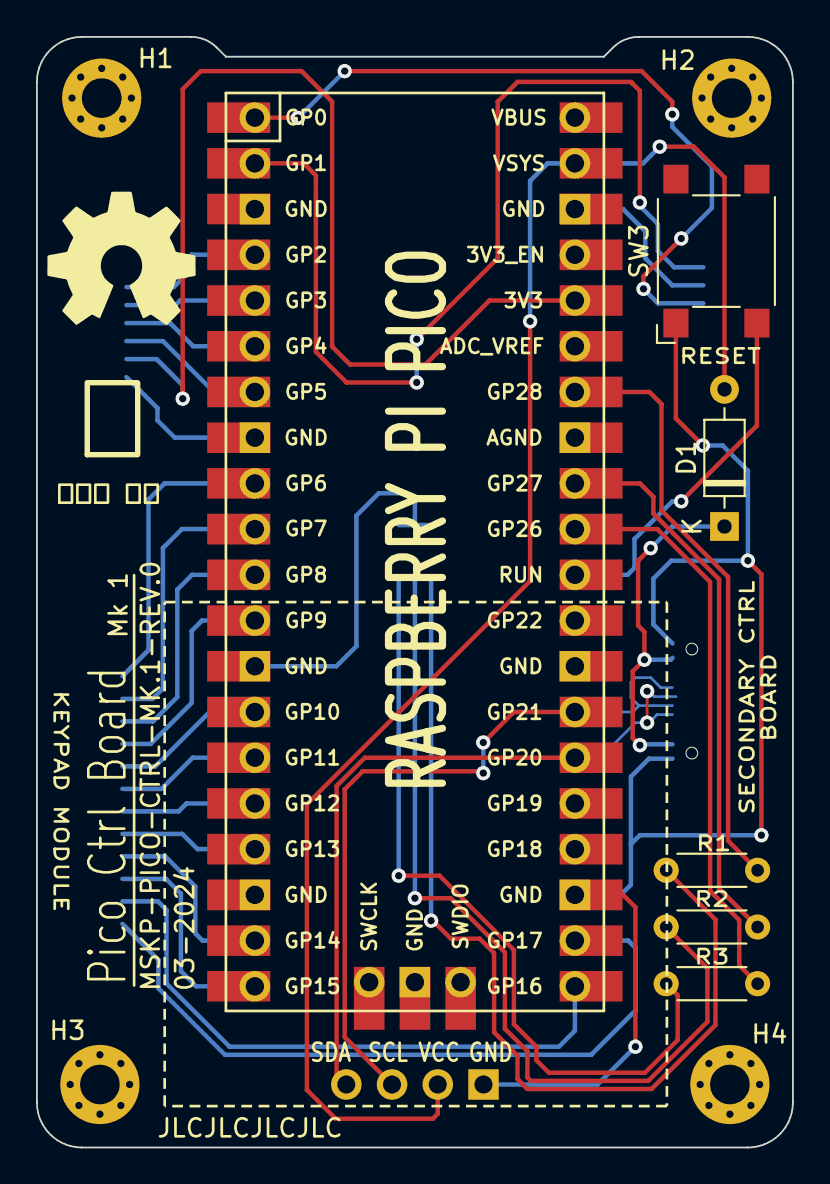
[picture p26: board pico_ctrl_board_primary_Mk1_rev0.kicad_pcb from above]

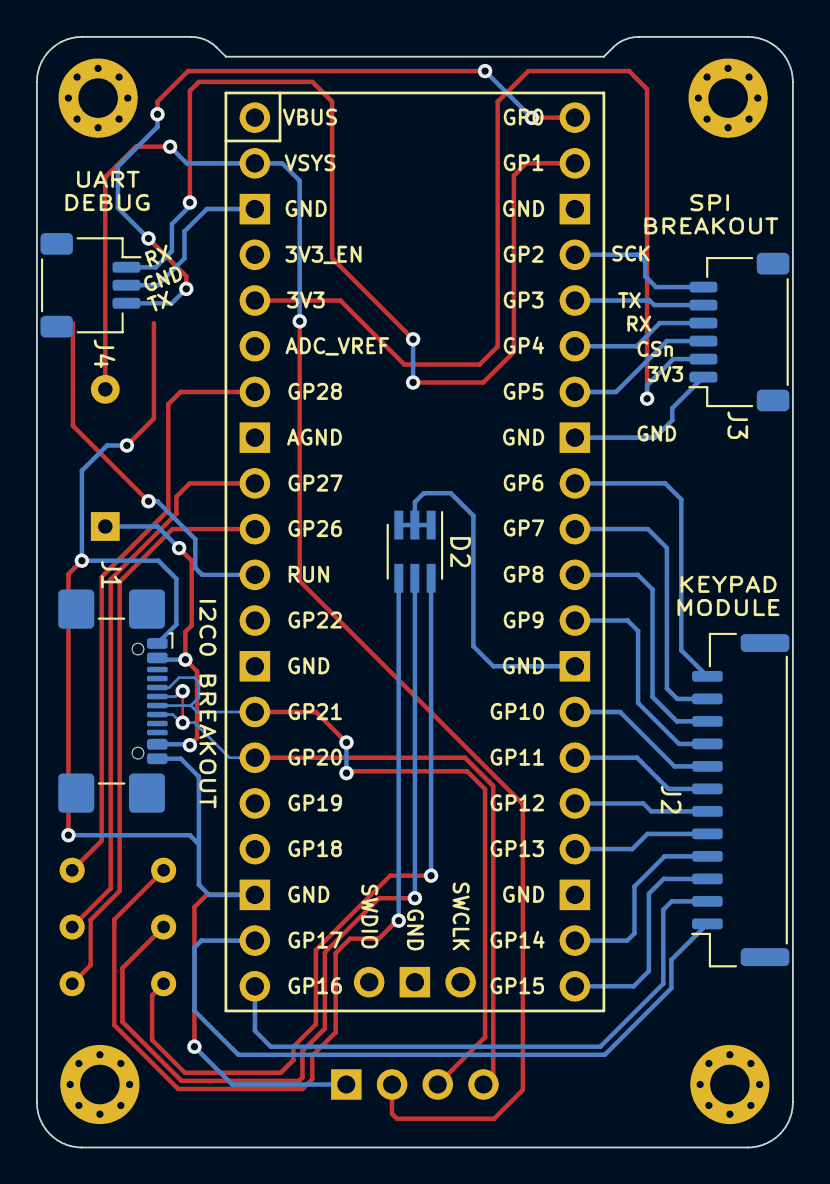
[picture p27: board pico_ctrl_board_primary_Mk1_rev0.kicad_pcb from below]

Board: 2 copper layers, 42.0 x 61.7 mm, 16 parts (5 on the bottom side), 34 nets.

Parts:
D1: 1N4148; D_DO-35_SOD27_P7.62mm_Horizontal
D2: ASMT-YTB7-0AA02; LED_Avago_PLCC6_3x2.8mm
H1, H2, H3, H4: MountingHole_2.2mm_M2_Pad_Via
J1: USB_C_Receptacle_USB2.0; USB_C_Receptacle_GCT_USB4110
J2: Conn_01x12_Socket; JST_GH_SM12B-GHS-TB_1x12-1MP_P1.25mm_Horizontal
J3: Conn_01x06_Socket; JST_SH_SM06B-SRSS-TB_1x06-1MP_P1.00mm_Horizontal
J4: Conn_01x03_Socket; JST_SH_SM03B-SRSS-TB_1x03-1MP_P1.00mm_Horizontal
R1, R2, R3: Resistor; R_Axial_DIN0204_L3.6mm_D1.6mm_P5.08mm_Horizontal
SW3: SW_Omron_B3FS; SW_SPST_Omron_B3FS-101xP
U1: Raspberry_Pi_Pico
U2: OLED_128x64

Connections:
GND: J4.2, U1.38 (GND)
unnamed: D1.2 (A), U1.39 (VSYS), U2.2 (VCC)
unnamed: D1.1 (K), J1.A4 (VBUS), J1.A9 (VBUS), J1.B4 (VBUS), J1.B9 (VBUS)
unnamed: D2.6 (AB), R3.1
unnamed: D2.5 (AG), R2.1
unnamed: D2.4 (AR), R1.1
unnamed: D2.1 (KB), D2.2 (KG), D2.3 (KR), U1.13 (GND)
unnamed: J2.1, U1.22 (GPIO17)
unnamed: J2.2, U1.21 (GPIO16)
unnamed: J2.3, U1.20 (GPIO15)
unnamed: J2.4, U1.19 (GPIO14)
unnamed: J2.5, U1.17 (GPIO13)
unnamed: J2.6, U1.16 (GPIO12)
unnamed: J2.7, U1.15 (GPIO11)
unnamed: J2.8, U1.14 (GPIO10)
unnamed: J2.9, U1.12 (GPIO9)
unnamed: J2.10, U1.11 (GPIO8)
unnamed: J2.11, U1.10 (GPIO7)
unnamed: J2.12, U1.9 (GPIO6)
unnamed: J3.1, U1.8 (GND)
unnamed: J3.2, U1.36 (3V3)
unnamed: J3.3, U1.7 (GPIO5)
unnamed: J3.4, U1.6 (GPIO4)
unnamed: J3.5, U1.5 (GPIO3)
unnamed: J3.6, U1.4 (GPIO2)
unnamed: J4.1, U1.2 (GPIO1)
unnamed: J4.3, U1.1 (GPIO0)
unnamed: J1.A6 (D+), J1.B6 (D+), U1.26 (GPIO20), U2.4 (SDA)
unnamed: J1.A7 (D-), J1.B7 (D-), U1.27 (GPIO21), U2.3 (SCL)
unnamed: R3.2, U1.31 (GPIO26_ADC0)
unnamed: R2.2, U1.32 (GPIO27_ADC1)
unnamed: R1.2, U1.34 (GPIO28_ADC2)
unnamed: SW3.2, U1.30 (RUN)
unnamed: J1.A1 (GND), J1.A12 (GND), J1.B1 (GND), J1.B12 (GND), SW3.1, U1.23 (GND), U2.1 (GND)
