Mon0x4A/custom-keyboard/c/vamk/mouse-handling/pmw3360_config.h

#ifndef PMW3360_CONFIG_H
#define PMW3360_CONFIG_H

///Imports
#include "vamk_config.h"

///Type Declarations
///Constants
#define TARGET_BAUDRATE_HZ 100000
#define PMW3360_SPI_INSTANCE spi0

#define PMW3360_SPI_CLOCK_GPIO 2
#define PMW3360_SPI_TX_GPIO 3
#define PMW3360_SPI_RX_GPIO 4

#define PMW3360_SPI_CS_COUNT 2
#define PMW3360_SPI_CS0_GPIO 5
#define PMW3360_SPI_CS1_GPIO 8

///Function Declarations

#endif
