Mon0x4A/custom-keyboard/c/vamk/key-handling/vamk_keyboard_state.c

///Imports
#include "stdbool.h"
#include "pico/stdlib.h"
#include "vamk_config.h"
#include "vamk_keymap_config.h"
#include "vamk_key_helper.h"
#include "vamk_key_state.h"
#include "vamk_keyboard_state.h"
#include "vamk_types.h"

///Static Constants
#define LAYER_MOD_VARIANT_COUNT 2
#define RIGHT_LAYER_MOD_BITMASK 0b00010000

static const uint8_t DEFAULT_LAYER_INDEX = 0;

///Static Types
struct layer_mod_state_container_s
{
    bool is_right_variant_pressed:1;
    bool is_left_variant_pressed:1;
};

///Static Global Variables
static volatile uint8_t _last_pressed_layer_index = 0;
static volatile struct layer_mod_state_container_s _layer_mod_state[MAX_LAYER_COUNT] = {0};

static volatile struct hid_keycode_container_t _repeat_code = {0};
static uint8_t _repeat_modifiers[HID_REPORT_KEYCODE_ARRAY_LENGTH] = {0};

///Static Functions
static void clear_repeat_modifers(void)
{
    for (int i = 0; i < HID_REPORT_KEYCODE_ARRAY_LENGTH; i++)
        _repeat_modifiers[i] = 0;
}

///Extern Functions
uint8_t keyboard_state_get_current_layer_index(void)
{
    // Just return the last layer pressed if available.
    if (_last_pressed_layer_index != 0)
        return _last_pressed_layer_index;

    // Otherwise start counting backwards by index.
    // TODO both these could easily be represented as a
    // layer queue in the future.
    for (uint8_t i = MAX_LAYER_COUNT-1; i > 0; i--)
    {
        if (keyboard_state_get_is_layer_index_pressed(i))
            return i;
    }

    // If nothing is pressed, return the default layer.
    return DEFAULT_LAYER_INDEX;
}

uint8_t keyboard_state_clear_sticky_layer(void)
{
    if (IS_LAYER_STICKY[_last_pressed_layer_index])
        _last_pressed_layer_index = 0;
}

bool keyboard_state_get_is_layer_index_pressed(uint8_t layer_index)
{
    return _layer_mod_state[layer_index].is_right_variant_pressed ||
        _layer_mod_state[layer_index].is_left_variant_pressed;
}
void keyboard_state_set_is_layer_keycode_pressed(uint8_t layer_keycode, bool is_layer_modifier_pressed)
{
    if (!key_helper_is_layer_modifier_keycode(layer_keycode))
        return;

    //The right variants all have 11(0xB) for their upper nibble. The left are 10(0xA).
    bool is_right_mod = layer_keycode & RIGHT_LAYER_MOD_BITMASK;
    uint8_t layer_index = key_helper_get_layer_index_from_layer_keycode(layer_keycode);
    volatile struct layer_mod_state_container_s * mod_container = &_layer_mod_state[layer_index];
    if (is_right_mod)
        mod_container->is_right_variant_pressed = is_layer_modifier_pressed;
    else
        mod_container->is_left_variant_pressed = is_layer_modifier_pressed;

    if (is_layer_modifier_pressed)
        _last_pressed_layer_index = layer_index;

    if (!is_layer_modifier_pressed && !IS_LAYER_STICKY[layer_index])
        _last_pressed_layer_index = 0;
}

bool keyboard_state_modifier_collection_contains_keycode(struct modifier_collection_t modifier_collection,
    uint8_t modifier_keycode)
{
    for (int i = 0; i < modifier_collection.modifier_count; i++)
    {
        if (modifier_keycode == modifier_collection.modifiers[i])
            return true;
    }
    return false;
}

bool keyboard_state_is_any_modifier_pressed(void)
{
    struct modifier_collection_t current_modifiers = keyboard_state_get_currently_pressed_modifiers();
    return current_modifiers.modifier_count != 0;
}
struct modifier_collection_t keyboard_state_get_currently_pressed_modifiers(void)
{
    // Grab the curret hid report state and search for modifiers.
    struct key_report_t report_preview = key_state_preview_hid_report();

    struct modifier_collection_t current_modifiers_container = {0};
    uint8_t current_insertion_index = 0;
    for (uint8_t i = 0; i < HID_REPORT_KEYCODE_ARRAY_LENGTH; i++)
    {
        uint8_t curr_report_hid_keycode = report_preview.keycodes[i];
        if (key_helper_is_modifier_keycode(curr_report_hid_keycode))
        {
            // Record any modifiers we find.
            current_modifiers_container.modifiers[current_insertion_index] = curr_report_hid_keycode;
            current_insertion_index++;
            current_modifiers_container.modifier_count = current_insertion_index;
        }
    }
    return current_modifiers_container;
}

void keyboard_state_set_repeat_state(struct hid_keycode_container_t hid_repeat_code)
{
    hard_assert(hid_repeat_code.has_valid_contents);
    _repeat_code = hid_repeat_code;

    clear_repeat_modifers();
    struct modifier_collection_t current_modifiers = keyboard_state_get_currently_pressed_modifiers();
    memcpy(&_repeat_modifiers, &current_modifiers.modifiers, HID_REPORT_KEYCODE_ARRAY_LENGTH);
}
void keyboard_state_send_repeat_state(void)
{
    if (!_repeat_code.has_valid_contents)
        return;

    for (int i = 0; i < HID_REPORT_KEYCODE_ARRAY_LENGTH; i++)
    {
        if(_repeat_modifiers[i] == 0)
            continue;

        // Send each valid modifier we recorded.
        struct hid_keycode_container_t modifier_code =
        {
            .hid_keycode = _repeat_modifiers[i],
            .modifier = 0,
            .has_valid_contents = true
        };
        key_state_press(modifier_code, true);
    }

    // Send our original repeat code. This has to be done last
    // so the new codes in the report are processed in order.
    key_state_press(_repeat_code, true);
}
