Mon0x4A/custom-keyboard/c/vamk/key-handling/vamk_switch_state.h

// Protect from multiple includes
#ifndef VAMK_SWITCH_STATE_H
#define VAMK_SWITCH_STATE_H

///Imports
#include "vamk_types.h"

///Function Declarations
void switch_state_init(void);
//void switch_state_task(void);
void switch_state_task_update(void);
void switch_state_task_process(void);
void switch_state_task_finalize(void);
void switch_state_set_pressed_callback(switch_pressed_callback_t pressed_callback);
void switch_state_set_released_callback(switch_released_callback_t released_callback);

#endif
