Mon0x4A/custom-keyboard/c/vamk/key-handling/vamk_key_state.h

// Protect from multiple includes
#ifndef VAMK_KEY_STATE_H
#define VAMK_KEY_STATE_H

///Imports
#include <stdbool.h>
#include "pico/stdlib.h"
#include "vamk_layer_info.h"

///Type Declarations
struct key_report_t
{
    uint8_t keycodes[6];
    uint8_t modifier;
};

///Function Declarations
struct key_report_t key_state_preview_hid_report(void);
struct key_report_t key_state_build_hid_report(void);
void key_state_press(struct hid_keycode_container_t keycode_container, bool should_press_for_minimal_time_and_auto_release);
void key_state_release(uint8_t hid_keycode);

#endif
