Mon0x4A/custom-keyboard/c/vamk/key-handling/vamk_press_helper.c

///Imports
#include <stdbool.h>
#include "pico/stdlib.h"
#include "vamk_config.h"
#include "vamk_keymap_config.h"
#include "vamk_key_helper.h"
#include "vamk_key_state.h"
#include "vamk_keyboard_state.h"
#include "vamk_layer_info.h"
#include "vamk_press_helper.h"
#include "vamk_types.h"
#include "win_macros.h"
#include "tusb.h"

///Static Global Variables
///Local Declarations

///Static Functions
static void keycode_press_internal(struct hid_keycode_container_t keycode_container,
    bool should_press_for_minimal_time_and_auto_release)
{
    // If we are receiving invalid codes, something has gone
    // programatically wrong.
    hard_assert(keycode_container.has_valid_contents);

    bool is_modifier_code = key_helper_is_modifier_keycode_container(keycode_container);

    // Remove any layer caching if we are resolving a sticky press.
    if (!is_modifier_code && keycode_container.hid_keycode != KC_NULL)
        keyboard_state_clear_sticky_layer();

    bool should_report_code = true;
    bool is_key_macro_code = false;
    void (*macro_func_ptr)(void) = NULL;
    switch (keycode_container.hid_keycode)
    {
        case KC_REPEAT:
            should_report_code = false;
            keyboard_state_send_repeat_state();
            break;
        case KC_WIN_IME_TOGGLE:
            should_report_code = false;
            is_key_macro_code = true;
            macro_func_ptr = &macro_windows_ime_toggle;
            break;
        case KC_WIN_ALPHA_SWAP:
            should_report_code = false;
            is_key_macro_code = true;
            macro_func_ptr = &macro_windows_alphabet_swap;
            break;
        case KC_KM_TOGGLE:
            static bool output_state = 0;
            if (output_state)
                gpio_pull_up(KM_SWITCH_SELECT_PIN);
            else
                gpio_pull_down(KM_SWITCH_SELECT_PIN);
            output_state ^= 1;
            break;
        case HID_KEY_ALT_LEFT:
        case HID_KEY_ALT_RIGHT:
            break;
        case HID_KEY_GUI_LEFT:
        case HID_KEY_GUI_RIGHT:
            break;
        case HID_KEY_CONTROL_LEFT:
        case HID_KEY_CONTROL_RIGHT:
            break;
        case HID_KEY_SHIFT_LEFT:
        case HID_KEY_SHIFT_RIGHT:
            break;
        case KC_NULL:
        //HID_KEY_NONE as well
            // Nothing to do if we hit a null code.
            should_report_code = false;
            break;
        default:
            break;
    }

    if (key_helper_is_layer_modifier_keycode(keycode_container.hid_keycode))
    {
        keyboard_state_set_is_layer_keycode_pressed(keycode_container.hid_keycode, true);
        should_report_code = false;
        printf("Entering layer %d\n", key_helper_get_layer_index_from_layer_keycode(keycode_container.hid_keycode));
    }

    if (ENABLE_KEYBOARD_COMMANDS && should_report_code)
    {
        key_state_press(keycode_container, should_press_for_minimal_time_and_auto_release);

        // Record last external operation as repeat metadata.
        if (!is_modifier_code)
            keyboard_state_set_repeat_state(keycode_container);
    }
    else if (ENABLE_KEYBOARD_COMMANDS && is_key_macro_code)
    {
        if (macro_func_ptr != NULL)
            (*macro_func_ptr)();
    }

    if (ENABLE_SERIAL_LOGGING && should_report_code)
    {
        printf("Keycode value pressed: %u\n", keycode_container.hid_keycode);
    }
}

///Extern Functions
void press_helper_key_press(struct hid_keycode_container_t keycode_container)
{
    keycode_press_internal(keycode_container, false);
}

void press_helper_momentary_press_with_modifiers(struct hid_keycode_container_t keycode_container,
    struct modifier_collection_t modifiers_collection)
{
    hard_assert(keycode_container.has_valid_contents);

    for (int i = 0; i < modifiers_collection.modifier_count; i++)
    {
        uint8_t modifier_code = modifiers_collection.modifiers[i];
        if (modifier_code == KC_NULL)
            continue;
        if (!key_helper_is_modifier_keycode(modifier_code))
            continue;

        struct hid_keycode_container_t modifier_code_container =
        {
            .hid_keycode = modifier_code,
            .modifier = 0,
            .has_valid_contents = true
        };
        press_helper_momentary_press(modifier_code_container);
    }

    press_helper_momentary_press(keycode_container);
}

void press_helper_momentary_press(struct hid_keycode_container_t keycode_container)
{
    keycode_press_internal(keycode_container, true);
}
