Mon0x4A/custom-keyboard/c/vamk/key-handling/vamk_release_helper.h

#ifndef HEADER_FILE_H
#define HEADER_FILE_H
///Imports
///Type Declarations
///Constants

///Function Declarations
void release_helper_key_release(struct hid_keycode_container_t keycode_container);

#endif
