Mon0x4A/custom-keyboard/c/vamk/tinyusb-config/tusb_implementation.h

#ifndef TUSB_IMPLEMENTATION_H
#define TUSB_IMPLEMENTATION_H

///Imports

///Function Declarations
void led_blinking_task(void);
void tud_mount_cb(void);
void tud_umount_cb(void);
void tud_suspend_cb(bool remote_wakeup_en);
void tud_resume_cb(void);
void tud_hid_report_complete_cb(uint8_t instance, uint8_t const* report, uint16_t len);
uint16_t tud_hid_get_report_cb(uint8_t instance, uint8_t report_id, hid_report_type_t report_type, uint8_t* buffer, uint16_t reqlen);
void tud_hid_set_report_cb(uint8_t instance, uint8_t report_id, hid_report_type_t report_type, uint8_t const* buffer, uint16_t bufsize);

#endif
