Mon0x4A/custom-keyboard/(commit log)

2022-06-13 Adds initial commit, structure and resources
    [switch_mx.stl, uploads_ad_a2_42_af_b4_cherry_mx.scad]
2022-06-13 Adds initial left back plate draft for keyboard
    [backplateLeft.scad]
2022-06-13 Renames left keyboard file and starts on housing + mock arduino
    [keybordLeft.scad]
2022-06-14 Adds a bunch of work on various keyboard parts. Now including keycaps.
    [cap-shank.stl, keybordLeft.scad]
2022-06-15 Tunes values of keycap shank fitment
    [keybordLeft.scad]
2022-06-15 Adds 2u keycap and risers for backplate attachment
    [keybordLeft.scad]
2022-06-15 Widens usb port, adds housing bolt throughs and adds arduino tabs
    [keybordLeft.scad]
2022-06-16 Renames main scad file, adds prototype housing test
    [keybordParts.scad]
2022-06-16 Adds key layout/backplate generation for right keyboard half
    [keybordParts.scad]
2022-06-16 More board tweaks based on protoyping
    [keybordParts.scad]
2022-06-17 Tweaks more based on prototype model, final tweaks before at-scale print
    [keybordParts.scad]
2022-06-18 Changes the housing depth back to 18, feels better.
    [keybordParts.scad]
2022-06-20 Slight tweaks to arduino size inside housing
    [keybordParts.scad]
2022-06-24 First draft at a functioning left half ino file
    [keybordParts.scad]
2022-06-25 Adjust arduino holder tabs and adds first draft at right half code
    [keybordParts.scad]
2022-06-26 Adds a variable padding to the top of each keycap for different heights
    [keybordParts.scad]
2022-06-29 Tweaks the key height tiers to 1mm increments.
    [keybordParts.scad]
2022-07-03 Adds housing supports for backplate
    [keybordParts.scad]
2022-07-07 Adds backstop for Arduino Micro built into housing
    [keybordParts.scad]
2022-08-12 Few small testing tweaks and sets default view to left side keyboard
    [keybordParts.scad]
2022-08-14 Changes a pin because soldering got messed up.
2022-08-30 Corrects grammar mistake and readies tab code to be more portable
    [keybordParts.scad]
2023-01-26 Renames keybordParts to Mk1 keyboard
    [customKeyboardMk1.scad]
2023-01-28 Initial commit of the Mk2 version of the keyboard
    [customKeyboardMk2.scad]
2023-01-28 Adjusts arduino mount and adds more edge support in middle
    [customKeyboardMk2.scad]
2023-01-28 Renames files to reflect the iteration structure
    [keyboardMk1.scad, keyboardMk2.scad]
2023-01-30 Slight variable rename
    [keyboardMk2.scad]
2023-02-11 Adds tabs for holding arduino
    [keyboardMk2.scad]
2023-02-12 Adds checking for printing and non-printing characters when changing sticky layer state
2023-02-12 Changes syntax to "layer shift" character instead of printing characters due to the actual function they serve
2023-02-13 Resets the scad file render
    [keyboardMk2.scad]
2023-02-18 Adds measurement print outs for keyboard housing size
    [keyboardMk2.scad]
2023-02-18 Adds first draft of tenting structure for mk2 keyboard
    [keyboardMk2.stl, keyboardTentingStructureMk2.scad]
2023-02-20 Adds bolt channel cutouts to carraige beams
    [keyboardTentingStructureMk2.scad]
2023-02-20 Begins cutouts on beam structures
    [keyboardTentingStructureMk2.scad]
2023-02-23 Adds triangle cutouts to the base beams
    [keyboardTentingStructureMk2.scad]
2023-02-24 Adds mod tap behavior to layer 1 modifiers and moves return key
    [keyboardTentingStructureMk2.scad]
2023-03-03 Adds cutouts for connecting base beam and starts on tent
    [keyboardTentingStructureMk2.scad]
2023-03-04 Begins on keyboardMk3 design with dual switch compat
    [keyboardMk2.scad, keyboardMk3.scad]
2023-03-05 Adds housing sub module code and basic locatin outline
    [keyboardMk3.scad]
2023-03-05 Adds support for 1.25u keys
    [keyboardMk3.scad]
2023-03-06 Refactors code after relizing two variable sets was a terrible idea
    [keyboardMk3.scad]
2023-03-07 Begins work on arduino housing and placement
    [keyboardMk2.scad, keyboardMk3.scad]
2023-03-07 Adds beginning of matching arduino housing and adjusts kailh plate heights
    [keyboardMk3.scad]
2023-03-08 Adds code for kailh switch to cap shank interface
    [keyboardMk3.scad]
2023-03-09 Adds first pass at kailh key cap top
    [keyboardMk3.scad]
2023-03-10 Adds cutouts for housing to clear the way for internals
    [keyboardMk3.scad]
2023-03-10 Sets up mirror call for right half rendering
    [keyboardMk3.scad]
2023-03-10 Fixes 'de-shift' issue on left shift
    When the Keyboard library calls write with a symbol that requires
    the shift button to print, the left shift is used in that call. As
    part of that call the (left) shift release is also called so now
    both shift button use the right shift code to avoid shift being
    disengaged while still physically held.
2023-03-11 Sets up and positions the arduino nut punch set
    [keyboardMk3.scad]
2023-03-11 Implements backplate risers with matching backplate bolt holes
    [keyboardMk3.scad]
2023-03-12 Adds housing backplate corner supports
    [keyboardMk3.scad]
2023-03-12 Adds straight risers to distances between corners
    [keyboardMk3.scad]
2023-03-12 Adds cover for arduino housing and adds cable routing
    [keyboardMk3.scad]
2023-03-14 Keycap and arduino sizing tweaks
    [keyboardMk3.scad]
2023-03-15 Adds the starting values for joining the main housing and the arduino housing. Also adds the pinout diagram for the micro controller.
    [keyboardMk3.scad]
2023-03-16 Tweaks kailh keycap design
    [keyboardMk3.scad]
2023-03-16 Adds support for 1inch oled screen
    [keyboardMk3.scad]
2023-03-17 Moves equals button back and removes OS tap events
2023-03-18 Oled screen adjustments and TRRS port initial draft
    [keyboardMk3.scad]
2023-03-19 More tweaks based on Arduino housing lid components
    [keyboardMk3.scad]
2023-03-19 Trims top of housing to avoid sharp corners
    [keyboardMk3.scad]
2023-03-19 Lowers kailh risers and patches housing render issues
    [keyboardMk3.scad]
2023-03-25 Right side switch matrix functional
2023-03-28 Removes shift tap command until i2c comms are added. Too many misfires.
2023-03-31 Condenses variable usage and adds arduino tab cutout
    [keyboardMk3.scad]
2023-04-06 Adds wedge block for securing the trrs port fixture
    [keyboardMk3.scad]
2023-04-19 Begins work on local and remote switch state providers over i2c
2023-04-20 Adds simple wrist pad shape
    [keyboardMk3.scad]
2023-04-21 Wrist rest tweaks
    [keyboardMk3.scad]
2023-04-29 Works on abstracting serial switch printing to helper
2023-04-29 Makes the matrix managers switch state providers
2023-04-30 Adds switch mechanical drawings
2023-05-02 Begins first testing drafts of trackball housing
    [trackballMacropadMk1.scad]
2023-05-02 Gets switch output functional by reducing operation count
2023-05-04 Reworks keyboard state objects to global scope to avoid crashes when dereferencing more than the board can handle
2023-05-05 Moves Wire logic outside of state provider to global context to prevent crashes. Uses function pointer to preserve structure.
2023-05-06 Gets i2c communication to round-trip
2023-05-13 Adds oled screen frame and covering plate for mk3 w/removed screens
    [keyboardMk3.scad]
2023-05-13 Deletes unused code and optimizes/fixes matrix printing
2023-05-15 Adds printed instructions for setting up the pico
2023-05-17 Updates two const arrays to match their references
    This appeared as a complier error in the v2 version
    of the arduino IDE.
2023-05-21 Adds initial resources for mk4 design
    [keyboardMk4.scad]
2023-05-21 Fixes indents and begins making space for pico
    [keyboardMk3.scad, keyboardMk4.scad]
2023-05-31 Adds pico documentation to resources
2023-05-31 Adjusts switch cutout sizes smaller
    [keyboardMk4.scad]
2023-06-04 Fixes the floating pin state on the Pico code
    This commit changes the way switch state is measured by
    setting the column pins to always be INPUT_PULLUP. The
    method of 'just in time' setting the pinMode() was causing
    the pin values to float irratically.
    [keyboardMk4.ino]
2023-06-04 Changes inset nut size smaller
    [keyboardMk4.scad]
2023-06-04 Implements housing sizing for pico
    [keyboardMk4.scad]
2023-06-05 Minor housing and comment tweaks
    [keyboardMk4.scad]
2023-06-06 Re-fixes cutout adjustment that somehow got undone
    [keyboardMk4.scad]
2023-06-10 Tweaks the pico housing top for first printing
    [keyboardMk4.scad]
2023-06-21 Adds changes to pin connections in mk4
2023-06-21 Adds initial commit of pico sdk firmware
2023-06-23 Moves led blink enum to types header
2023-06-24 Reworks h files with ifndef and begins switch polling structure
    [vamk.c, vamk_config.h, vamk_switch_state.c, vamk_switch_state.h, vamk_types.h]
2023-06-25 Adds the logic to poll switch states and printf it
2023-06-28 Adds insertion, contains and removal methods to hid report
2023-07-01 Adds serial code output and bug fixes
    [vamk.c, vamk_config.h, vamk_layer_info.c, vamk_switch_state.c]
2023-07-01 Fixes to get basic layer 0 keycodes sending!
    [vamk.c, vamk_config.h, vamk_key_state.c, vamk_layer_info.c]
2023-07-02 Creates structure for reading peripheral switch state
2023-07-02 Adds support for keyboard sides in switch/key handling
2023-07-03 Adds basic test code to transmit over I2C
2023-07-06 Begins work on mk5 unibody design
    [keyboardMk5.scad]
2023-07-06 Adds cable ramp cutouts and attaches to keyboard housing
    [keyboardMk5.scad]
2023-07-07 Beginning to build up bridge section
    [keyboardMk5.scad]
2023-07-07 Adds initial bridge backplate sizing
    [keyboardMk5.scad]
2023-07-07 Adds grid decorations, punches and screen cover to bridge
    [keyboardMk5.scad]
2023-07-08 Adds all risers and finishes trimming matrix housing
    [keyboardMk5.scad]
2023-07-08 Adds lid for coupling housing
    [keyboardMk5.scad]
2023-07-08 Adds allowances for usbc breakout passthrough
    [keyboardMk5.scad]
2023-07-09 Adds cable cutouts for the relevant lids
    [keyboardMk5.scad]
2023-07-12 Adds center bridge cutout and corrects 'enter' HID keycode
    [keyboardMk5.scad]
2023-07-14 Raises mk5 pico housing lid
    [keyboardMk5.scad]
2023-07-15 Adds pin config for unibody keyboard
2023-07-15 Fixes 'single report' function with report countdown
    [vamk_key_state.c]
2023-07-16 Left side control code is causing issues for tap chords. Temp fix.
    [vamk_config.h]
2023-07-17 Mod fixes and makes curr layer index evaluation jit
    [vamk_config.h, vamk_keyboard_state.c, vamk_keyboard_state.h]
2023-07-19 Adds first draft of mk5 usbc clamp
    [keyboardMk5.scad]
2023-07-26 Adds initial (working) commit of minor i2c oled api
2023-07-29 Updates the usbc clamp design with increased surface area
    [keyboardMk5.scad]
2023-08-01 Adds repeat key functionality to current tap command
2023-08-03 Refactors kailh keycap out into its own file
    [kailhKeycapMk1.scad, keyboardMk3.scad, keyboardMk4.scad, keyboardMk5.scad]
2023-08-09 Flattens keycap top and shortens shank to prevent snaps
    [kailhKeycapMk2.scad]
2023-08-16 Updates and fixes for mk2 keycap design
    [kailhKeycapMk2.scad]
2023-08-20 Begins mk6 scad revisions
    [keyboardMk6.scad]
2023-08-22 Gets hold delay key printing functional
2023-08-26 Adjusts kailh cap tolerances and mx backplate
    [kailhKeycapMk2.scad, keyboardMk6.scad]
2023-08-28 Begins implementation of i/o expander housing
    [keyboardMk6.scad]
2023-08-29 Smoothing/QoL tweaks for mk6 housing code
    [keyboardMk6.scad]
2023-09-07 Removes case statements now that tap event saves layer
2023-09-09 Switches away from side logic, condenses keymap code
2023-10-14 Adds the 2 tap layer back, still getting cutoff issues
    Merge: Removes io expander calls in vamk.c will leave
    those to be dealt with on the specific branch.
    [vamk.c, vamk_layer_info.c]
2023-10-14 Adds first draft of qlp-22 kicad project
    [qlp-22_Mk1_rev0.kicad_pcb, qlp-22_Mk1_rev0.kicad_sch]
2023-10-15 Begins restructuring of qlp-22 to matrix layout
    [qlp-22_Mk1_rev0.kicad_pcb]
2023-10-16 Continues traces for matrix qlp-22 layout
    [qlp-22_Mk1_rev0.kicad_pcb]
2023-10-17 Adds row traces and comments for additional components
    [qlp-22_Mk1_rev0.kicad_pcb]
2023-10-18 Adds reset button, breakouts for uart, i2c1 and debug
    [qlp-22_Mk1_rev0.kicad_pcb]
2023-10-18 Reworks row traces and pin breakouts for qlp-22
    [qlp-22_Mk1_rev0.kicad_pcb]
2023-10-19 Revises left hand centering back to original location
    [qlp-22_Mk1_rev0.kicad_pcb]
2023-10-20 Aligns f.Cu for left half of qpl-22
    [qlp-22_Mk1_rev0.kicad_pcb]
2023-10-21 Finishes revisions to f.Cu on qlp-22
    [qlp-22_Mk1_rev0.kicad_pcb]
2023-10-21 Aligns b.Cu layer of qlp-22
    [qlp-22_Mk1_rev0.kicad_pcb]
2023-10-21 Creates initial pcb edge outline for qlp-22
    [qlp-22_Mk1_rev0.kicad_pcb]
2023-10-22 Adds rounded edges and initial mounting holes to qlp-22
    [qlp-22_Mk1_rev0.kicad_pcb]
2023-10-22 Begins silkscreening qlp-22
    [qlp-22_Mk1_rev0.kicad_pcb]
2023-10-22 Adds front qlp-22 silkscreen for all switches and diodes
    [qlp-22_Mk1_rev0.kicad_pcb]
2023-10-24 Revises and labels front and back qlp-22 silkscreen
    [qlp-22_Mk1_rev0.kicad_pcb]
2023-11-02 Adds 1.5u setting to kailhKeycapMk2
    [kailhKeycapMk2.scad]
2023-11-03 Corrects I2C variable usage in display code
    [vamk.c, vamk_config.h]
2023-11-06 Corrects formatting for qlp layer arrays
    [vamk_keymap_config.h]
2023-11-07 Fixes issue with layer 5 and 6 getting stuck/crashing
    [vamk_keymap_config.h, vamk_layer_info.c]
2023-11-17 Resizes the kailh choc cap to more standard size
    [kailhKeycapMk2.scad]
2023-11-22 Begins work on qlp-22_Mk1_rev1 ergo positions
    [qlp-22_Mk1_rev1.kicad_pcb, qlp-22_Mk1_rev1.kicad_sch]
2023-11-23 Adds remaining footprints for qlp-22_Mk1_rev1 pcb
    [qlp-22_Mk1_rev1.kicad_pcb]
2023-11-24 Adds starts of row/col tracks and sets board outline
    [qlp-22_Mk1_rev1.kicad_pcb]
2023-11-24 Places initial mounting holes
    [qlp-22_Mk1_rev1.kicad_pcb]
2023-11-30 Removes fCu dimensions, adds silkscreen to qlp-22_Mk1_rev1
    [qlp-22_Mk1_rev1.kicad_pcb]
2023-12-01 Finalizes diode positions for qlp-22_Mk1_rev1
    [qlp-22_Mk1_rev1.kicad_pcb]
2023-12-04 Adds more row wiring to right side
    [qlp-22_Mk1_rev1.kicad_pcb]
2023-12-07 Adds the row and column buses for qlp-22_Mk1_rev1
    [qlp-22_Mk1_rev1.kicad_pcb]
2023-12-09 Adds majority of column hookups for qlp-22_Mk1_rev1
    [qlp-22_Mk1_rev1.kicad_pcb]
2023-12-13 Adds row connections and diode/switch labels
    [qlp-22_Mk1_rev1.kicad_pcb]
2024-01-15 Prevents setting of keyboard chord state on null keycode
    [vamk_press_helper.c]
2024-01-15 Adds pin labels for qlp-22_Mk1_rev1
    [qlp-22_Mk1_rev1.kicad_pcb]
2024-01-17 Finishes labeling for qlp-22_Mk1_rev1
    [qlp-22_Mk1_rev1.kicad_pcb]
2024-01-18 Adds initial project files and layout for seok-38
    [seok-38_Mk1_rev0.kicad_pcb, seok-38_Mk1_rev0.kicad_sch]
2024-01-19 Adds left half edgecuts for seok-38_Mk1_rev0
    [seok-38_Mk1_rev0.kicad_pcb]
2024-01-20 Completes the edge cuts for seok-38_Mk1_rev0
    [seok-38_Mk1_rev0.kicad_pcb]
2024-01-21 Adjusts qlp-22_Mk1_rev1 tracks around mounting holes
    [qlp-22_Mk1_rev1.kicad_pcb]
2024-01-21 Adds the row wiring for seok-38_Mk1_rev0
    [seok-38_Mk1_rev0.kicad_pcb]
2024-01-22 Adds column wiring to seok-38_Mk1_rev0
    [seok-38_Mk1_rev0.kicad_pcb]
2024-01-24 Completes row hookups for seok-38_Mk1_rev0
    [seok-38_Mk1_rev0.kicad_pcb]
2024-01-24 Completes column hookups for seok-38_Mk1_rev0
    [seok-38_Mk1_rev0.kicad_pcb]
2024-01-25 Completes row/col silkscreen for seok-38_Mk1_rev0
    [seok-38_Mk1_rev0.kicad_pcb]
2024-01-25 Add final silkscreen labelling to seok-38_Mk1_rev0
    [seok-38_Mk1_rev0.kicad_pcb]
2024-01-26 DRC and silkscreen updates
    [qlp-22_Mk1_rev1.kicad_pcb, seok-38_Mk1_rev0.kicad_pcb]
2024-01-29 Final silkscreen and DRC tweaks before manufacturing
    [qlp-22_Mk1_rev1.kicad_pcb, seok-38_Mk1_rev0.kicad_pcb]
2024-01-29 Final final tweaks before manufacturing (lol)
    [qlp-22_Mk1_rev1.kicad_pcb, seok-38_Mk1_rev0.kicad_pcb]
2024-02-04 Various bug fixes toward better key registration
    This commit contains work towards ironing out issues
    with double tap events firing and rolling modifier
    functionality.
    [vamk_config.h, vamk_key_helper.c, vamk_key_helper.h, vamk_keyboard_state.c, vamk_keyboard_state.h, vamk_press_helper.c]
2024-02-09 Sets the hold delay timer back down. Too long.
    [vamk_config.h]
2024-02-13 Adds user layer 1 for mounting hole highlights on qlp_22_rev1
    [qlp-22_Mk1_rev1.kicad_pcb]
2024-02-18 Adds user layer highlights for case in seok-38_Mk1_rev0
    [seok-38_Mk1_rev0.kicad_pcb]
2024-02-21 Reworks single report into minimal key press code
    [vamk_key_state.c, vamk_key_state.h, vamk_press_helper.c, vamk_press_helper.h]
2024-02-22 Begins schematics for PCB-based modular keyboard design
    [mksp_Mk1_rev0.kicad_pcb, mksp_Mk1_rev0.kicad_sch, peripheral-ctrl-board.kicad_sch, pi-pico-main-ctrl-board.kicad_sch, qlp-22-keypad_L.kicad_sch, qlp-22-keypad_R.kicad_sch]
2024-02-26 Removes the mksp_Mk1_rev0 project in favor of board-specific projects
    [io_ctrl_board_secondary_Mk1_rev0.kicad_pcb, io_ctrl_board_seconday_Mk1_rev0.kicad_sch, mksp_Mk1_rev0.kicad_sch, pico_ctrl_board_primary_Mk1_rev0.kicad_pcb, pico_ctrl_board_primary_Mk1_rev0.kicad_sch, qlp-22-keypad_R.kicad_sch, qlp-22_mx_hs_keypad_L_Mk1_rev0.kicad_pcb, qlp-22_mx_hs_keypad_L_Mk1_rev0.kicad_sch]
2024-02-26 Adds basic layout and edges for qlp-22_mx_hs_keypad_L_Mk1_rev0
    [qlp-22_mx_hs_keypad_L_Mk1_rev0.kicad_pcb]
2024-02-26 Add filet, diodes to qlp-22_mx_hs_keypad_L_Mk1_rev0
    [qlp-22_mx_hs_keypad_L_Mk1_rev0.kicad_pcb]
2024-02-29 Adds wiring for qlp-22_mx_hs_keypad_L_Mk1_rev0
    [qlp-22_mx_hs_keypad_L_Mk1_rev0.kicad_pcb, qlp-22_mx_hs_keypad_L_Mk1_rev0.kicad_sch]
2024-02-29 Revert "temp" - was not suppose to be committed
    This reverts commit e45093a3f8baf3b457fb0748b04553bc07554a26.
    [qlp_22_rev1_keymap.h, vamk_key_state.c, vamk_keymap_config.h]
2024-02-29 Adds slightly shorter press for system mods
    [vamk_key_state.c]
2024-03-01 Initial work on pico_ctrl_board_primary_Mk1_rev0 layout
    [pico_ctrl_board_primary_Mk1_rev0.kicad_pcb, pico_ctrl_board_primary_Mk1_rev0.kicad_sch]
2024-03-02 Fixes missing header file inclusion
    [vamk_key_state.c]
2024-03-03 More work on pico layout and start of io shema layout
    [io_ctrl_board_secondary_Mk1_rev0.kicad_sch, pico_ctrl_board_primary_Mk1_rev0.kicad_pcb, pico_ctrl_board_primary_Mk1_rev0.kicad_sch]
2024-03-04 Adds qlp-22_mx_hs_keypad_R_Mk1_rev0 with initial layout
    [qlp-22_mx_hs_keypad_R_Mk1_rev0.kicad_pcb, qlp-22_mx_hs_keypad_R_Mk1_rev0.kicad_sch]
2024-03-04 Adds wiring for qlp-22_mx_hs_keypad_R_Mk1_rev0
    [qlp-22_mx_hs_keypad_R_Mk1_rev0.kicad_pcb, qlp-22_mx_hs_keypad_R_Mk1_rev0.kicad_sch]
2024-03-04 Adds work on io_ctrl_board_secondary_Mk1_rev0 pcb
    [io_ctrl_board_secondary_Mk1_rev0.kicad_pcb, io_ctrl_board_secondary_Mk1_rev0.kicad_sch]
2024-03-06 More work on io_ctrl_board_secondary_Mk1_rev0 layout and schema
    [io_ctrl_board_secondary_Mk1_rev0.kicad_pcb, io_ctrl_board_secondary_Mk1_rev0.kicad_sch]
2024-03-08 Adds logo and OSH symbol to all mskp silkscreens
    [io_ctrl_board_secondary_Mk1_rev0.kicad_pcb, io_ctrl_board_secondary_Mk1_rev0.kicad_sch, pico_ctrl_board_primary_Mk1_rev0.kicad_pcb, qlp-22_mx_hs_keypad_L_Mk1_rev0.kicad_pcb, qlp-22_mx_hs_keypad_R_Mk1_rev0.kicad_pcb]
2024-03-08 Partial work on mskp part silkscreens
    [io_ctrl_board_secondary_Mk1_rev0.kicad_pcb, qlp-22_mx_hs_keypad_L_Mk1_rev0.kicad_pcb]
2024-03-09 Adds wiring for pico_ctrl_board_primary_Mk1_rev0
    [pico_ctrl_board_primary_Mk1_rev0.kicad_pcb, pico_ctrl_board_primary_Mk1_rev0.kicad_sch]
2024-03-09 Adds wiring for io_ctrl_board_secondary_Mk1_rev0
    [io_ctrl_board_secondary_Mk1_rev0.kicad_pcb, io_ctrl_board_secondary_Mk1_rev0.kicad_sch]
2024-03-09 Adds mounting holes to qlp-22_mx_hs_keypad_R_Mk1_rev0
    [qlp-22_mx_hs_keypad_R_Mk1_rev0.kicad_pcb]
2024-03-10 Polishes silkscreen on io_ctrl_board_secondary_Mk1_rev0
    [io_ctrl_board_secondary_Mk1_rev0.kicad_pcb]
2024-03-10 Tweaks and fixes for seok_38_rev0
    [seok_38_rev0_keymap_m.h, vamk.c, vamk_config.h, vamk_keymap_constants.h, vamk_press_helper.c]
2024-03-11 Cleans up unneeded files and adds more silkscreen tidy
    [io_ctrl_board_secondary_Mk1_rev0.kicad_pcb, io_ctrl_board_seconday_Mk1_rev0.kicad_sch, pico_ctrl_board_primary_Mk1_rev0.kicad_pcb, qlp-22_mx_hs_keypad_L_Mk1_rev0.kicad_pcb]
2024-03-11 Minor silkscreen and makes connector flush with PCB edge
    [qlp-22_mx_hs_keypad_L_Mk1_rev0.kicad_pcb]
2024-03-14 Finalizes mskp pcbs before first run
    [io_ctrl_board_secondary_Mk1_rev0.kicad_pcb, pico_ctrl_board_primary_Mk1_rev0.kicad_pcb, qlp-22_mx_hs_keypad_L_Mk1_rev0.kicad_pcb, qlp-22_mx_hs_keypad_R_Mk1_rev0.kicad_pcb]
2024-03-15 Adds all simple case files for recent PCBs
    [mskp-qlp-rev0-test-case.scad, qlp-22_rev1_jank_case.scad, seok-38_rev0_jank_case.scad]
2024-03-15 Adds user layer for bolt risers on two PCBs
    [pico_ctrl_board_primary_Mk1_rev0.kicad_pcb, qlp-22_mx_hs_keypad_L_Mk1_rev0.kicad_pcb]
2024-03-15 Adds firmware setting for LED blink and fixes pointer call
    [vamk.c, vamk_config.h, vamk_press_helper.c]
2024-03-18 Partial work on mskp-qlp basic case
    [datahand-palm-rest.stl, mskp-qlp-rev0-test-case.scad]
2024-03-18 Updates the pico pcb riser holes to play nicer with extruding
    [pico_ctrl_board_primary_Mk1_rev0.kicad_pcb]
2024-03-23 Adds right side case to mskp qlp test case
    [io_ctrl_board_secondary_Mk1_rev0.kicad_pcb, mskp-qlp-rev0-test-case.scad, qlp-22_mx_hs_keypad_R_Mk1_rev0.kicad_pcb]
2024-04-02 Adds a copy of the pico board to start a rev1
    [pico_ctrl_board_primary_Mk1_rev1.kicad_pcb, pico_ctrl_board_primary_Mk1_rev1.kicad_sch]
2024-04-02 Begins work on seok-42_mx_keypad_L_Mk1_rev0
    [seok-42_mx_keypad_L_Mk1_rev0.kicad_pcb, seok-42_mx_keypad_L_Mk1_rev0.kicad_sch]
2024-04-05 Adds safety check if peripheral read fails
    [vamk_peripheral_switch_state.c]
2024-04-05 Initial work on seok-42_mx_keypad_L_Mk1_rev0 layout
    [seok-42_mx_keypad_L_Mk1_rev0.kicad_pcb, seok-42_mx_keypad_L_Mk1_rev0.kicad_sch]
2024-04-09 Adds design to boost qlp to 24 keys
    [qlp-24_mx_keypad_L_Mk1_rev0.kicad_pcb, qlp-24_mx_keypad_L_Mk1_rev0.kicad_sch]
2024-04-11 Minor keypad design update ideas
    [qlp-22_mx_hs_keypad_L_Mk1_rev0.kicad_pcb, qlp-24_mx_keypad_L_Mk1_rev0.kicad_pcb, seok-42_mx_keypad_L_Mk1_rev0.kicad_pcb]
2024-04-11 Adds plate cutout lines to User2 of qlp-22_mx_hs_keypad_L_Mk1_rev0
    [qlp-22_mx_hs_keypad_L_Mk1_rev0.kicad_pcb]
2024-04-11 Adds backplate designs for mskp qlp case
    [mskp-qlp-rev0-test-case.scad, qlp-22_mx_hs_keypad_L_Mk1_rev0.kicad_pcb, qlp-22_mx_hs_keypad_R_Mk1_rev0.kicad_pcb]
2024-04-11 Corrects case svgs and separates 3D models
    [mskp-qlp-rev0-test-case.scad]
2024-04-23 Add diodes positions to seok-42_mx_keypad_L_Mk1_rev0
    [seok-42_mx_keypad_L_Mk1_rev0.kicad_pcb]
2024-04-23 Add initial board outline for seok-42_mx_keypad_L_Mk1_rev0
    [seok-42_mx_keypad_L_Mk1_rev0.kicad_pcb]
2024-05-13 Minor pcb updates for qlp and seok keypads
    [qlp-24_mx_keypad_L_Mk1_rev0.kicad_pcb, seok-42_mx_keypad_L_Mk1_rev0.kicad_pcb]
2024-06-09 Add timeout for i2c write instruction call
    This commit attempts to solve a issue where the
    i2c_write_blocking method would hang indefinitely
    in the event that a write instruction was not
    acknowledged, thus never receives a return. The
    change to i2c_write_blocking_until, timeout and
    retry seems to help resolve this issue.
    [vamk_peripheral_switch_state.c]
2024-06-09 Moves peripheral key handler to correct directory
    [vamk_peripheral_switch_state.c, vamk_peripheral_switch_state.h]
2024-06-20 Sync switch state modules
2024-06-20 Adds informative logging for i2c retry logic
2024-06-30 Adds sleep to prevent io expander lockup
    This commit adds a sleep_us (microsecond) call before
    any register write operation happens. The intention is
    to prevent the io expander from recieving too many commands
    at once and seizing up.
    [vamk_peripheral_switch_state.c]
2024-07-28 Adds sleep fix for 2 row key misfires. Correct method params.
    This commit adds a fix for 2 row matrices not having
    enough time to bring the pin state LOW before testing
    another matrix location. Additionally, fixes for a pin
    lookup method in the peripheral state code not being
    passed params. Other changes are for variable name style
    refactors.
    [vamk_peripheral_switch_state.c, vamk_switch_state.c]
2024-08-30 Gets initial pmw3360 spi api compiling
2024-08-30 Adds first draft of usbc switch board schematic
    [usbc_switch_board_Mk1_rev0.kicad_pcb, usbc_switch_board_Mk1_rev0.kicad_sch]
2024-09-02 Remove unused ctrl mk1r1 in favor of mk2 first draft schematic
    [pico_ctrl_board_primary_Mk1_rev1.kicad_pcb, pico_ctrl_board_primary_Mk1_rev1.kicad_sch, pico_ctrl_board_primary_Mk2_rev0.kicad_pcb, pico_ctrl_board_primary_Mk2_rev0.kicad_sch, usbc_switch_board_Mk1_rev0.kicad_sch]
2024-09-07 Adds first drafts of adc mouse and io expander mk2
    [dual_axis_i2c_analog_mouse_Mk1_rev0.kicad_pcb, dual_axis_i2c_analog_mouse_Mk1_rev0.kicad_sch, io_ctrl_board_secondary_Mk2_rev0.kicad_pcb, io_ctrl_board_secondary_Mk2_rev0.kicad_sch, pico_ctrl_board_primary_Mk2_rev0.kicad_sch, usbc_switch_board_Mk1_rev0.kicad_sch]
2024-09-13 Further refinement of first drafts adding specific components
    [dual_axis_i2c_analog_mouse_Mk1_rev0.kicad_sch, io_ctrl_board_secondary_Mk2_rev0.kicad_sch, pico_ctrl_board_primary_Mk2_rev0.kicad_sch, usbc_switch_board_Mk1_rev0.kicad_sch]
2024-09-16 Initital footprint assignment to all control boards
    [dual_axis_i2c_analog_mouse_Mk1_rev0.kicad_pcb, dual_axis_i2c_analog_mouse_Mk1_rev0.kicad_sch, io_ctrl_board_secondary_Mk2_rev0.kicad_pcb, io_ctrl_board_secondary_Mk2_rev0.kicad_sch, pico_ctrl_board_primary_Mk2_rev0.kicad_pcb, pico_ctrl_board_primary_Mk2_rev0.kicad_sch, usbc_switch_board_Mk1_rev0.kicad_pcb, usbc_switch_board_Mk1_rev0.kicad_sch]
2024-09-16 Upgrades keypad designs to KiCAD 8
    [qlp-24_mx_keypad_L_Mk1_rev0.kicad_pcb, qlp-24_mx_keypad_L_Mk1_rev0.kicad_sch, seok-42_mx_keypad_L_Mk1_rev0.kicad_pcb, seok-42_mx_keypad_L_Mk1_rev0.kicad_sch]
2024-09-21 Begins rough PCB part grouping for all control board revisions
    [dual_axis_i2c_analog_mouse_Mk1_rev0.kicad_pcb, io_ctrl_board_secondary_Mk2_rev0.kicad_pcb, pico_ctrl_board_primary_Mk2_rev0.kicad_pcb, pico_ctrl_board_primary_Mk2_rev0.kicad_sch, usbc_switch_board_Mk1_rev0.kicad_pcb]
2024-09-21 Continues work with rough PCB outlines
    [dual_axis_i2c_analog_mouse_Mk1_rev0.kicad_pcb, io_ctrl_board_secondary_Mk2_rev0.kicad_pcb, pico_ctrl_board_primary_Mk2_rev0.kicad_pcb, seok-42_mx_keypad_L_Mk1_rev0.kicad_pcb, usbc_switch_board_Mk1_rev0.kicad_pcb]
2024-09-23 Refining PCB outlines for pico and io control boards
    [io_ctrl_board_secondary_Mk2_rev0.kicad_pcb, pico_ctrl_board_primary_Mk2_rev0.kicad_pcb, pico_ctrl_board_primary_Mk2_rev0.kicad_sch, usbc_switch_board_Mk1_rev0.kicad_pcb, usbc_switch_board_Mk1_rev0.kicad_sch]
2024-09-23 Refines usb and mouse control boards with outline and GND
    [dual_axis_i2c_analog_mouse_Mk1_rev0.kicad_pcb, usbc_switch_board_Mk1_rev0.kicad_pcb]
2024-09-30 Initial layout work on pico_ctrl_board_primary_Mk2_rev0 PCB
    [pico_ctrl_board_primary_Mk2_rev0.kicad_pcb, pico_ctrl_board_primary_Mk2_rev0.kicad_sch]
2024-10-05 Initial layout of PCB traces on io_ctrl_board_secondary_Mk2_rev0
    [io_ctrl_board_secondary_Mk2_rev0.kicad_pcb, io_ctrl_board_secondary_Mk2_rev0.kicad_sch]
2024-10-07 Initial PCB layout for usbc_switch_board_Mk1_rev0
    [usbc_switch_board_Mk1_rev0.kicad_pcb]
2024-10-09 Initial layout of dual_axis_i2c_analog_mouse_Mk1_rev0 PCB traces
    [dual_axis_i2c_analog_mouse_Mk1_rev0.kicad_pcb, dual_axis_i2c_analog_mouse_Mk1_rev0.kicad_sch]
2024-10-17 Add design files for lpk-24_mx_keypad_R_Mk1_rev0
    [lpk-24_mx_keypad_R_Mk1_rev0.kicad_pcb, lpk-24_mx_keypad_R_Mk1_rev0.kicad_sch]
2024-10-21 Adds lpk20_mx_keypad_Mk1_rev0 PCB designs
    [lpk20_mx_keypad_L_Mk1_rev0.kicad_pcb, lpk20_mx_keypad_L_Mk1_rev0.kicad_sch, lpk20_mx_keypad_R_Mk1_rev0.kicad_pcb, lpk20_mx_keypad_R_Mk1_rev0.kicad_sch]
2024-10-25 Adds initial PCB layout for seok-42_mx_keypad_Mk1_rev0
    [seok-42_mx_keypad_L_Mk1_rev0.kicad_pcb]
2024-10-26 Adds initial PCB layout for seok42_mx_keypad_R_Mk1_rev0
    [seok42_mx_keypad_R_Mk1_rev0.kicad_pcb, seok42_mx_keypad_R_Mk1_rev0.kicad_sch]
2024-10-28 Adds silkscreen for pico_ctrl_board_primary_Mk2_rev0
    [pico_ctrl_board_primary_Mk2_rev0.kicad_pcb]
2024-10-30 Adds io_ctrl_board_secondary_Mk2_rev0 silkscreen
    [io_ctrl_board_secondary_Mk2_rev0.kicad_pcb]
2024-11-02 Adds silkscreen to usbc_switch_board_Mk1_rev0 PCB
    [usbc_switch_board_Mk1_rev0.kicad_pcb]
2024-11-02 Adds silkscreen for dual_axis_i2c_analog_mouse_Mk1_rev0 PCB
    [dual_axis_i2c_analog_mouse_Mk1_rev0.kicad_pcb, dual_axis_i2c_analog_mouse_Mk1_rev0.kicad_sch]
2024-11-04 Adds the silkscreen for lpk20_mx_keypad_L_Mk1_rev0 PCB
    [lpk20_mx_keypad_L_Mk1_rev0.kicad_pcb]
2024-11-04 Adds silkscreen for lpk20_mx_keypad_R_Mk1_rev0 PCB
    [lpk20_mx_keypad_R_Mk1_rev0.kicad_pcb]
2024-11-04 Adds silkscreen for seok-42_mx_keypad_L_Mk1_rev0 PCB
    [seok-42_mx_keypad_L_Mk1_rev0.kicad_pcb]
2024-11-04 Adds silkscreen for seok42_mx_keypad_R_Mk1_rev0 PCB
    [seok42_mx_keypad_R_Mk1_rev0.kicad_pcb]
2024-11-08 Final tweaks to PCBs before second round of mskp fabrications
    [dual_axis_i2c_analog_mouse_Mk1_rev0.kicad_pcb, io_ctrl_board_secondary_Mk2_rev0.kicad_pcb, lpk20_mx_keypad_L_Mk1_rev0.kicad_pcb, lpk20_mx_keypad_R_Mk1_rev0.kicad_pcb, pico_ctrl_board_primary_Mk2_rev0.kicad_pcb, seok-42_mx_keypad_L_Mk1_rev0.kicad_pcb, seok42_mx_keypad_R_Mk1_rev0.kicad_pcb, usbc_switch_board_Mk1_rev0.kicad_pcb]
2024-11-22 Adds initial case and backplate work for lpk20_mk1
    [lpk20_L_case.scad, lpk20_mx_keypad_L_Mk1_rev0.kicad_pcb]
2024-12-22 Updates mskp pcbs with case design layers
    [dual_axis_i2c_analog_mouse_Mk1_rev0.kicad_pcb, io_ctrl_board_secondary_Mk2_rev0.kicad_pcb, lpk20_mx_keypad_L_Mk1_rev0.kicad_pcb, lpk20_mx_keypad_R_Mk1_rev0.kicad_pcb, pico_ctrl_board_primary_Mk2_rev0.kicad_pcb, usbc_switch_board_Mk1_rev0.kicad_pcb]
2024-12-22 Adds new mskp lpk20 test cases
    [lpk20_L_case.scad, lpk20_R_case.scad]
2024-12-23 Add initial mounting puck model
    [lpk20_L_case.scad, mounting-puck.scad]
2025-03-05 Fixes improper release loop and increases IO sleep for stability
    [mcp23017_i2c_api.c, vamk_key_logic.c, vamk_key_state.c]
2025-04-05 Corrects unused loop variable
    [vamk_key_logic.c]
2025-04-05 Prevents unnecessary reads from polluting i2c bus
    [vamk_peripheral_switch_state.c, vamk_switch_state.c]
2025-04-05 Additional delay check at timer resolution
2025-04-05 Adds ctrl to base of esc/enter
2025-04-23 Adds initial implementaion of variable delay timer
2025-09-13 Adds lpk_dactyl models for printing
    [croissant-left.3mf, croissant-left.stl, croissant-right.3mf, croissant-right.stl, key_cover.scad, lpk_dactyl_mk1.scad, lpk_dactyl_mk2.scad, usbc_mount.scad]
2025-10-31 Updates lpk20 dactyl designs
    [lpk20_L_case.scad, lpk20_R_case.scad, lpk_dactyl_mk1.scad]
